Nkyoku/toro10_repo/TORO10Board/BOM.xlsx

Device | Model Number | Value | Package | Qty | Parts
Resistor |  | 0Ω | 1608 | 16 | R62, R64, R65, R67, R73, R75, R76, R78, R84, R86, R87, R89, R95, R97, R98, R100
Resistor | WSLF25121L000FEA (https://www.digikey.jp/product-detail/ja/vishay-dale/WSLF25121L000FEA/541-3125-1-ND/6194698) | 1mΩ | WSLF2512 | 1 | R5
Resistor |  | 2mΩ | 3216 | 8 | R63, R66, R74, R77, R85, R88, R96, R99
Resistor | PRL1632-R005-F-T1 (https://www.digikey.jp/product-detail/ja/susumu/PRL1632-R005-F-T1/PRL1632.005FCT-ND/948857) | 5mΩ | 3216WL | 2 | R24, R25
Resistor |  | 1Ω | 1608 | 5 | R60, R71, R82, R93, R104
Resistor |  | 51Ω | 1608 | 6 | R6, R7, R31, R32, R36, R43
Resistor |  | 1kΩ | 1608 | 14 | R4, R17, R29, R30, R51, R52, R69, R70, R80, R81, R91, R92, R102, R103
Resistor |  | 2.2kΩ | 1608 | 7 | R21, R33, R44, R45, R49, R53, R54
Resistor |  | 3.3kΩ | 1608 | 1 | R19
Resistor |  | 4.7kΩ | 1608 | 5 | R20, R27, R28, R39, R41
Resistor |  | 10kΩ | 1608 | 8 | R2, R10, R40, R46, R47, R48, R50, R55
Resistor |  | 15kΩ | 1608 | 1 | R12
Resistor |  | 22kΩ | 1608 | 6 | R9, R14, R61, R72, R83, R94
Resistor |  | 33kΩ | 1608 | 1 | R23
Resistor |  | 47kΩ | 1608 | 4 | R11, R16, R18, R105
Resistor |  | 68.1kΩ | 1608 | 1 | R22
Resistor |  | 130kΩ | 1608 | 2 | R13, R15
Resistor |  | 180kΩ | 1608 | 1 | R26
Resistor |  | 220kΩ | 1608 | 2 | R1, R3
Resistor |  | 270kΩ | 1608 | 1 | R8
Resistor Array |  | 51Ωx4 | 3216 | 5 | R34, R35, R37, R38, R42
Resistor Array |  | 1kΩx4 | 3216 | 4 | R56, R57, R58, R59
Resistor Array |  | 100kΩx4 | 3216 | 5 | R68, R79, R90, R101, R106
Ceramic Capacitor |  | Do Not Mount | 1608 | 8 | C54, C56, C67, C69, C82, C84, C95, C97
Ceramic Capacitor |  | 100pF | 1608 | 1 | C19
Ceramic Capacitor |  | 1nF | 1608 | 2 | C14, C20
Ceramic Capacitor |  | 10nF | 1608 | 3 | C17, C29, C38
Ceramic Capacitor |  | 100nF 63V | 1608 | 72 | C2, C3, C6, C21, C27, C28, C31, C40, C41, C46, C47, C48, C49, C50, C51, C52, C53, C55, C61, C62, C63, C64, C65, C66, C68, C74, C75, C76, C77, C78, C79, C80, C81, C83, C89, C90, C91, C92, C93, C94, C96, C102, C103, C104, C105, C106, C107, C108, C110, C111, C112, C113, C114, C115, C116, C117, C118, C119, C120, C121, C122, C123, C124, C125, C126, C127, C128, C129, C130, C131, C132, C133
Ceramic Capacitor |  | 1uF 63V | 1608 | 30 | C4, C5, C7, C16, C30, C32, C33, C34, C35, C37, C42, C43, C44, C45, C57, C58, C59, C60, C70, C71, C72, C73, C85, C86, C87, C88, C98, C99, C100, C101
Ceramic Capacitor | GRM21BB31E106KA (http://akizukidenshi.com/catalog/g/gP-07388/) | 10uF 16V | 2012 | 7 | C8, ,C9, C10, C15, C18, C39, C109
Ceramic Capacitor | GRM32ER7YA106KA12 (http://akizukidenshi.com/catalog/g/gP-06043/) | 10uF 35V | 3225 | 2 | C22, C23
Ceramic Capacitor | GRM32ER71J106MA12L (https://www.digikey.jp/product-detail/ja/murata-electronics-north-america/GRM32ER71J106MA12L/490-9971-1-ND/5026476) | 10uF 63V | 3225 | 2 | C24, C25
Ceramic Capacitor | GRM21BR61E226ME44 (http://akizukidenshi.com/catalog/g/gP-08240/) | 22uF 6.3V | 2012 | 1 | C36
Aluminum Capacitor | 35PK47MEFC5X11 (http://akizukidenshi.com/catalog/g/gP-03120/) | 47uF 35V | φ5mm | 1 | C1
Aluminum Capacitor | 25PK100MEFC5X11 (http://akizukidenshi.com/catalog/g/gP-03122/) | 100uF 16V | φ5mm | 3 | C11, C12, C13
Aluminum Capacitor | UPW1J391MHD6 (https://www.digikey.jp/product-detail/ja/nichicon/UPW1J391MHD6/493-1947-ND/589688) | 390uF 63V | φ18mm | 1 | C26
Inductor | MAMK2520T4R7M (https://www.digikey.jp/product-detail/ja/taiyo-yuden/MAMK2520T4R7M/587-3228-1-ND/3479462) | 4.7uH | 2520 | 5 | L1, L2, L3, L4, L5
Inductor | IHLP6767GZER8R2M11 (https://www.digikey.jp/product-detail/ja/vishay-dale/IHLP6767GZER8R2M11/541-1285-1-ND/2139411) | 8.2uH | 17.15mm x 17.15mm | 2 | L6, L7
Ferrite Bead | BLM18PG471SN1D (http://akizukidenshi.com/catalog/g/gP-04444/) |  | 1608 | 1 | FB1
Polyswitch | MICROSMD010F-02 (http://akizukidenshi.com/catalog/g/gP-09514/) |  | 3225 | 6 | F1, F2, F3, F4, F5, F6
Silicon Diode | GS1010FL (http://akizukidenshi.com/catalog/g/gI-06014/) |  | SOD123 | 10 | D11, D14, D15, D16, D17, D18, D19, D20, D21, D22
Schottky Diode | SS2040FL (http://akizukidenshi.com/catalog/g/gI-02073/) |  | SOD123 | 4 | D2, D3, D4, D5
Schottky Diode | FSV2060L (https://www.digikey.jp/product-detail/ja/fairchild-on-semiconductor/FSV2060L/FSV2060LCT-ND/5725011) |  | TO-277-3 | 2 | D7, D8
TVS Diode | SMAJ26A (https://www.digikey.jp/product-detail/ja/littelfuse-inc/SMAJ26A/SMAJ26ALFCT-ND/762502) |  | DO-214AC | 1 | D1
TVS Diode | SMAJ48A (https://www.digikey.jp/product-detail/ja/littelfuse-inc/SMAJ48A/SMAJ48ALFCT-ND/762516) |  | DO-214AC | 2 | D9, D10
LED |  | Green | 1608 | 1 | D12
LED |  | Orange | 1608 | 1 | D6
LED |  | Red | 1608 | 1 | D13
NPN Transistor | 2SC2712-GR (http://akizukidenshi.com/catalog/g/gI-00761/) |  | SOT23-3 | 2 | Q2, Q6
Nch MOSFET | BSS138 (http://akizukidenshi.com/catalog/g/gI-04232/) |  | SOT23-3 | 7 | Q1, Q3, Q4, Q5, Q10, Q11, Q12
Nch MOSFET | TPN7R506NH,L1Q (https://www.digikey.jp/product-detail/ja/toshiba-semiconductor-and-storage/TPN7R506NH,L1Q/TPN7R506NHL1QCT-ND/4876002) |  | TSON-8_3.3 | 2 | Q8, Q9
Pch MOSFET | SI7135DP-T1-GE3 (https://www.digikey.jp/product-detail/ja/vishay-siliconix/SI7135DP-T1-GE3/SI7135DP-T1-GE3CT-ND/1978869) |  | POWERPAK-SO-8-S | 1 | Q7
LDO Regulator | SPX3819M5-L-5-0/TR (https://www.digikey.jp/product-detail/ja/exar-corporation/SPX3819M5-L-5-0-TR/1016-1874-1-ND/3586591) |  | SOT23-5 | 1 | U10
Buck Regulator | LT3504EUFD#PBF (https://www.digikey.jp/product-detail/ja/linear-technology/LT3504EUFD-PBF/LT3504EUFD-PBF-ND/3481903) |  | QFN28-0.5 | 1 | U2
Boost Regulator | LTC3862EUH-1#PBF (https://www.digikey.jp/product-detail/ja/linear-technology/LTC3862EUH-1-PBF/LTC3862EUH-1-PBF-ND/1985771) |  | QFN24-0.65 | 1 | U3
Serializer | SN74LV165APWRG3 (https://www.digikey.jp/product-detail/ja/texas-instruments/SN74LV165APWRG3/296-31867-1-ND/3506089) |  | TSSOP16 | 2 | U11, U12
A/D Conveter | ADS7223SRHBT (https://www.digikey.jp/product-detail/ja/texas-instruments/ADS7223SRHBT/296-28186-1-ND/2522330) |  | QFN32-0.5 | 1 | U9
Oscillator | ASDMB-30.000MHZ-LC-T (https://www.digikey.jp/product-detail/ja/abracon-llc/ASDMB-30.000MHZ-LC-T/535-11733-1-ND/2809952) |  | 2520 | 1 | X1
EEPROM | 24AA02E48T-I/OT (https://www.digikey.jp/product-detail/ja/microchip-technology/24AA02E48T-I-OT/24AA02E48T-I-OTCT-ND/2003468) |  | SOT23-5 | 1 | U7
Flash Memory | IS25LP016D-JNLE (https://www.digikey.jp/product-detail/ja/issi-integrated-silicon-solution-inc/IS25LP016D-JNLE/706-1583-ND/6624232) |  | SOP8 | 1 | U5
I/O Expander | PCAL6416AHF,128 (https://www.digikey.jp/product-detail/ja/nxp-usa-inc/PCAL6416AHF,128/568-9946-1-ND/3721126) |  | QFN24-0.5 | 1 | U6
Motor Driver | DRV8312DDWR (https://www.digikey.jp/product-detail/ja/texas-instruments/DRV8312DDWR/296-29649-1-ND/2756423) |  | HTSSOP44 | 1 | U25
Motor Driver | DRV8332DKDR (https://www.digikey.jp/product-detail/ja/texas-instruments/DRV8332DKDR/296-29572-1-ND/2754251) |  | HSSOP36 | 4 | U13, U16, U19, U22
Inertial Measurement Unit | ICM-20689 (https://www.digikey.jp/product-detail/ja/invensense/ICM-20689/1428-1059-1-ND/5872874) |  | QFN24 | 1 | U8
Current Sense Amplifier | INA219AIDCNR (https://www.digikey.jp/product-detail/ja/texas-instruments/INA219AIDCNR/296-23770-1-ND/1952550) |  | SOT23-8 | 1 | U1
Current Sense Amplifier | INA240A2PWR (https://www.digikey.jp/product-detail/ja/texas-instruments/INA240A2PWR/296-45089-1-ND/6562102) |  | TSSOP8 | 8 | U14, U15, U17, U18, U20, U21, U23, U24
FPGA | 10M16SCE144C8G (https://www.digikey.jp/product-detail/ja/altera/10M16SCE144C8G/544-3111-ND/5284835) |  | QFP144 | 1 | U4
Piezoelectric Sounder | PKLCS1212E4001-R1 (http://akizukidenshi.com/catalog/g/gP-05723/) |  | PKLCS1212 | 1 | BZ1
Toggle Switch | B-12JV (http://akizukidenshi.com/catalog/g/gP-07658/) |  | B-12JV | 1 | SW1
Tactile Switch | EVQ-PUB02K (https://www.digikey.jp/product-detail/ja/panasonic-electronic-components/EVQ-PUB02K/P10848SCT-ND/286349) |  | EVQ-PU_BK | 2 | SW2, SW3
Header | 3557-20 (https://www.digikey.jp/product-detail/ja/keystone-electronics/3557-20/36-3557-20-ND/6149526) |  | 3557 | 1 | CN2
Header | 0430450801 (https://www.digikey.jp/product-detail/ja/molex-llc/0430450801/WM3253-ND/2405169) |  | 43045-0800 | 5 | CN3, CN12, CN14, CN16, CN18
Header | 0534260410 (https://www.digikey.jp/products/ja?keywords=53426-0410) |  | 53426-04 | 5 | CN11, CN13, CN15, CN17, CN19
Header | 0039301040 (https://www.digikey.jp/product-detail/ja/molex-llc/0039301040/WM1352-ND/561079) |  | 5569-04A2 | 1 | CN1
Pin Header | Pin Header 1x2 2.54mm Pitch |  | PIN1X2 | 2 | CN4, CN5
Pin Header | Pin Header 1x3 2.54mm Pitch |  | PIN1X3 | 1 | J1
Pin Header | Pin Header 1x8 2.54mm Pitch |  | PIN1X8 | 1 | CN20
Pin Header | Pin Header 2x3 2.54mm Pitch |  | PIN2X3 | 1 | CN8
Pin Header | Pin Header 2x5 1.27mm Pitch |  | PIN2X5-TH1.27 | 1 | CN10
Pin Header | Pin Header 2x5 2.54mm Pitch |  | PIN2X5 | 1 | CN9, J2
Pin Socket | 2209S-10G (http://akizukidenshi.com/catalog/g/gC-03870/) |  | SOCKET1X10-TH2.0 | 2 | CN6, CN7
