Nkyoku/toro10_repo/TORO10KickerBoard/BOM.xlsx

Device | Model Number | Value | Package | Qty | Parts
Resistor | WSL4026L3000FEB (https://www.digikey.jp/product-detail/ja/vishay-dale/WSL4026L3000FEB/WSLR-.0003CT-ND/2695229) | 0.3mΩ | WSL4026 | 1 | R26
Resistor |  | 10mΩ | 3216 | 1 | R19
Resistor |  | 10Ω | 2012 | 4 | R37, R38, R39, R40
Resistor |  | 10Ω | 3216 | 1 | R17
Resistor |  | 100Ω | 1608 | 3 | R1, R2, R18
Resistor |  | 1kΩ | 1608 | 4 | R7, R8, R22, R28
Resistor | PFS35-1KF1 (https://www.digikey.jp/product-detail/ja/riedon/PFS35-1KF1/696-1276-1-ND/2447886) | 1kΩ | D2PAK-3 | 1 | R32
Resistor |  | 1.5kΩ | 1608 | 1 | R16
Resistor |  | 2.2kΩ | 1608 | 4 | R3, R4, R5, R6
Resistor |  | 4.7kΩ | 1608 | 2 | R33, R34
Resistor |  | 10kΩ | 1608 | 4 | R9, R24, R25, R27
Resistor |  | 18kΩ ±1% | 1608 | 1 | R14
Resistor |  | 39kΩ ±1% | 1608 | 2 | R13, R15
Resistor | KTR18EZPF1003 (https://www.digikey.jp/product-detail/ja/rohm-semiconductor/KTR18EZPF1003/RHM100KAICT-ND/1984017) | 100kΩ ±1% | 3216 | 4 | R20, R21, R29, R30
Resistor |  | 180kΩ ±1% | 1608 | 1 | R12
Resistor |  | 330kΩ ±1% | 1608 | 1 | R10
Resistor |  | 510kΩ ±1% | 1608 | 1 | R11
Resistor | KTR18EZPF1004 (https://www.digikey.jp/product-detail/ja/rohm-semiconductor/KTR18EZPF1004/RHM1MAICT-ND/4071440) | 1MΩ | 3216 | 1 | R31
Resistor |  | Do Not Mount | 1608 | 2 | R35, R36
Potentiometer | TC33X-2-501E (https://www.digikey.jp/product-detail/ja/bourns-inc/TC33X-2-501E/TC33X-2-501ECT-ND/3437927) | 500Ω | TC33X | 1 | R23
Ceramic Capacitor |  | 1nF | 1608 | 1 | C14
Ceramic Capacitor |  | 10nF | 1608 | 2 | C15, C16
Ceramic Capacitor | GRM31BR72J103KW01L (https://www.digikey.jp/product-detail/ja/murata-electronics-north-america/GRM31BR72J103KW01L/490-3512-1-ND/789417) | 10nF 630V | 3225 | 1 | C17
Ceramic Capacitor |  | 100nF | 1608 | 8 | C3, C4, C8, C9, C10, C18, C19, C21
Ceramic Capacitor |  | 1uF | 1608 | 4 | C1, C2, C7, C20
Ceramic Capacitor | GRM21BB31E106KA (http://akizukidenshi.com/catalog/g/gP-07388/) | 10uF 16V | 2012 | 3 | C5, C6, C11
Ceramic Capacitor | GRM32ER7YA106KA12 (http://akizukidenshi.com/catalog/g/gP-06043/) | 10uF 35V | 3225 | 1 | C13
Aluminum Capacitor | 35ZLH220MEFCCT8X11.5 (http://akizukidenshi.com/catalog/g/gP-11758/) | 220uF | φ8mm | 1 | C12
Transformer | B64290L0638X087 (https://www.digikey.jp/product-detail/ja/epcos-tdk/B64290L0638X087/495-3865-ND/1830195) |  | TRANS-23.3X12.6X7.4 | 1 | K1
Fuse | 0501010.WR (https://www.digikey.jp/product-detail/ja/littelfuse-inc/0501010.WR/F1625CT-ND/2620103) | 10A | 3216 | 1 | F1
Ferrite Bead | BLM18PG471SN1D (http://akizukidenshi.com/catalog/g/gP-04444/) |  | 1608 | 1 | FB1
Silicon Diode | ES3G-E3/57T (https://www.digikey.jp/product-detail/ja/vishay-semiconductor-diodes-division/ES3G-E3-57T/ES3G-E3-57TGICT-ND/1091579) |  | DO-214AB | 1 | D5
Silicon Diode | AS4PG-M3/86A (https://www.digikey.jp/product-detail/ja/vishay-semiconductor-diodes-division/AS4PG-M3-86A/AS4PG-M3-86AGICT-ND/2709013) |  | SMPC | 2 | D8, D9
Schottky Diode | RB520S-30 (http://akizukidenshi.com/catalog/g/gI-05566/) |  | 1608 | 1 | D1
TVS Diode | SMAJ26A (https://www.digikey.jp/product-detail/ja/littelfuse-inc/SMAJ26A/SMAJ26ALFCT-ND/762502) |  | DO-214AC | 1 | D2
TVS Diode | SMAJ300A (https://www.digikey.jp/product-detail/ja/littelfuse-inc/SMAJ300A/SMAJ300ALFCT-ND/762560) |  | DO-214AC | 1 | D6
LED |  | Red | 1608 | 1 | D7
LED |  | Green | 1608 | 2 | D3
LED |  | Orange | 1608 | 2 | D4
Nch MOSFET | BSS138 (http://akizukidenshi.com/catalog/g/gI-04232/) |  | SOT23-3 | 3 | Q1, Q2, Q4
Nch MOSFET | BSP130,115 (https://www.digikey.jp/product-detail/ja/nexperia-usa-inc/BSP130,115/1727-4928-1-ND/2531507) |  | SOT223 | 1 | Q5
Nch MOSFET | CSD19538Q3A (https://www.digikey.jp/product-detail/ja/texas-instruments/CSD19538Q3A/296-44352-1-ND/6110625) |  | Q3A | 1 | Q3
IGBT |  |  | D2PAK-3 | 4 | Q6, Q7, Q8, Q9
Linear Regulator | NJM7805SDL1 (http://akizukidenshi.com/catalog/g/gI-11237/) |  | DPAK-3 | 1 | U2
Linear Regulator | NJM7812SDL1 (http://akizukidenshi.com/catalog/g/gI-10978/) |  | DPAK-3 | 1 | U1
Boost Regulator | LT3751EUFD#PBF (https://www.digikey.jp/product-detail/ja/linear-technology/LT3751EUFD-PBF/LT3751EUFD-PBF-ND/1973298) |  | QFN20-0.5-4X5 | 1 | U4
Current Sense Amplifier | INA181A1IDBVT (https://www.digikey.jp/product-detail/ja/texas-instruments/INA181A1IDBVT/296-46634-1-ND/7219070) |  | SOT23-6 | 1 | U5
Gate Driver | UCC27524DGNR, UCC27524ADGNR |  | MSOP8-PAD | 1 | U6
Microcontroller | ATSAMC21E18A-AUT (https://www.digikey.jp/product-detail/ja/microchip-technology/ATSAMC21E18A-AUT/1611-ATSAMC21E18A-AUTCT-ND/6832701) |  | QFP32-0.8 | 1 | U3
Header | 0436500800 (https://www.digikey.jp/product-detail/ja/molex-llc/0436500800/WM2424-ND/531340) |  | 43650-0800 | 1 | CN2
Header | 0039301020 (https://www.digikey.jp/product-detail/ja/molex-llc/0039301020/WM1351-ND/561078) |  | 5569-02A2 | 2 | CN5, CN6
Header | 0039301040 (https://www.digikey.jp/product-detail/ja/molex-llc/0039301040/WM1352-ND/561079) |  | 5569-04A2 | 1 | CN4
Pin Header | Pin Header 1x4 2.54mm Pitch |  | PIN1X4 | 1 | CN1
Pin Header | Pin Header 2x5 1.27mm Pitch |  | PIN2X5-SMT1.27 | 1 | CN3
