Nkyoku/toro10_repo/TORO10KickerBoard/design/LT3751.asc

C1: cap; 10n
C2: cap; 20u
C3: cap; 10n
D1: schottky; UPSC600
L1: ind2; 10u
L2: ind2; 1000u
M1: nmos; Si4486EY
R1: res; 100k
R2: res; 1MEG
R3: res; 5.1k
R4: res; 39k
R5: res; 18k
R6: res; 39k
R7: res; 10m
R8: res; 1.5k
R9: res; 180k
R11: res; 330k
R12: res; 510k
R13: res; 10
U1: LT3751
V1: voltage; 24
V2: voltage; PWL(0 0 +10u 2)
V3: voltage; 12
Named nets: 0, Vout, Vtrans, Vcc
K1 L1 L2 0.999
.tran 1
