Nkyoku/toro10_repo/TORO10Board/design/boost.asc

C1: cap; 10u; Rser=10m
C2: cap; 1n
C3: cap; 100n
C4: cap; 10n
C5: cap; 100p
C6: cap; 470u; Rser=50m
C7: cap; 10u; Rser=10m
D1: schottky; B560C
D2: schottky; B560C
L1: ind; 8.2u; Rser=8m
L2: ind; 8.2u; Rser=8m
M1: nmos; NTMFS5C646NL
M2: nmos; NTMFS5C646NL
R1: res; 5m
R2: res; 5m
R3: res; 68.1k
R4: res; 475k
R5: res; 12.4k
R6: res; 100
R8: res; 33k
U1: LTC3862-1
V1: voltage; PWL(0 0 100u 24)
V2: voltage; PWL(0 0 1m 0 +1u 3)
Named nets: 0, Vin, Vout
.tran 100m
