Nkyoku/toro10_repo/TORO10Board/design/surge.asc

C1: cap; 1m
C2: cap; 100n
D1: schottky; MBRB2545CT
M1: nmos; BSS123
M2: pmos; HAT1072H
M3: nmos; BSS123
M4: nmos; BSS123
M5: nmos; BSS123
Q1: npn; 2N3904
Q2: npn; 2N3904
R1: res; 100
R2: res; 220k
R3: res; 220k
R4: res; 10k
R5: res; 1k
V1: voltage; PWL(0 0 +100u 24 100m 24 +100u 0)
V2: voltage; PWL(0 0 1m 0 +10u 5 80m 5 +10u 0)
Named nets: 0, Vout
.tran 150m
