Nkyoku/toro10_repo/TORO10KickerBoard/toro10kicker.brd

## EAGLE design TORO10KickerBoard/toro10kicker.brd (2017-08-24)

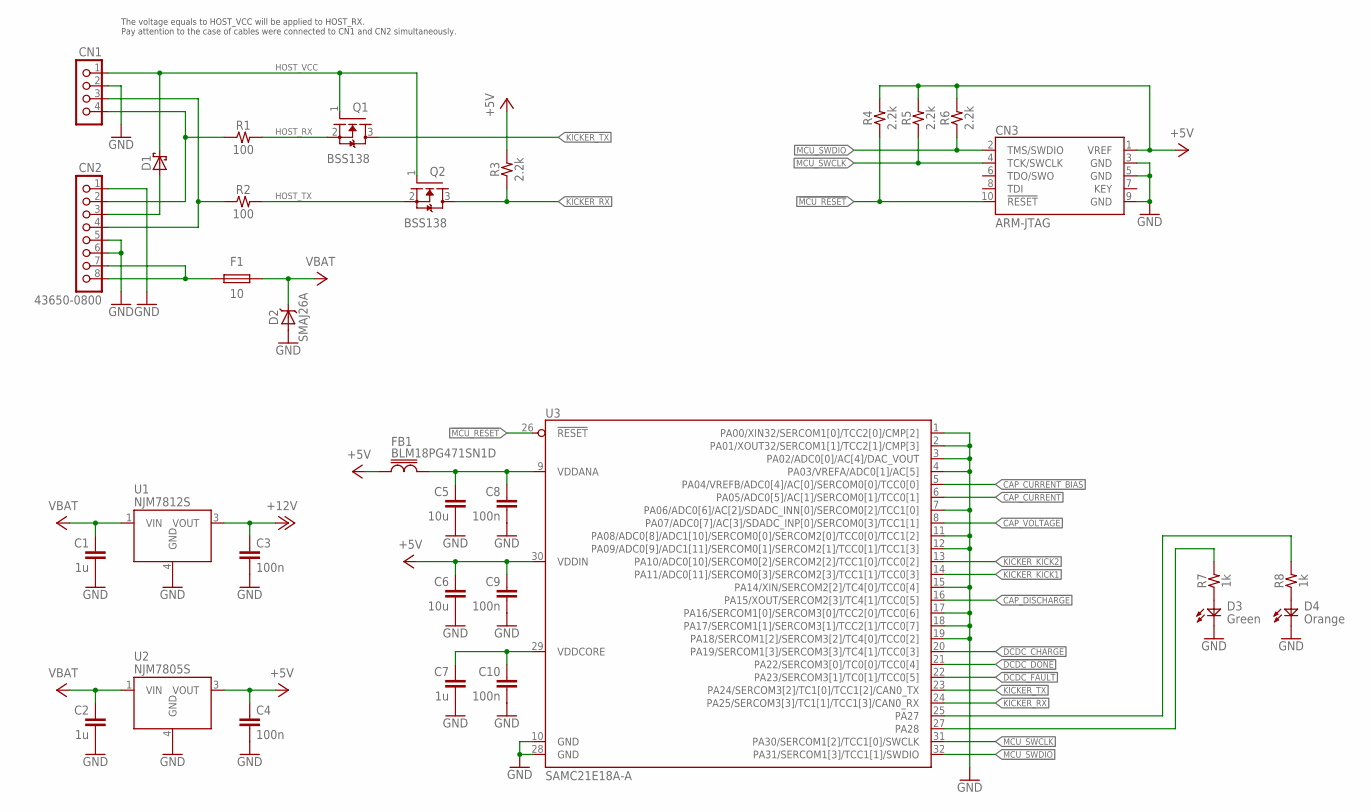
[picture p1: schematic toro10kicker.sch, sheet 1, Controller]

Parts:
C1, C2, C7: 1u; 1608
C3, C4, C8, C9, C10: 100n; 1608
C5, C6: 10u; 2012
CN1: PIN1X4
CN2: 43650-0800
CN3: ARM-JTAG; PIN2X5-SMT1.27
D1: SBD-1608; 1608D
D2: SMAJ26A; DO-214AC
D3: Green; 1608D
D4: Orange; 1608D
F1: 10; 3216
FB1: BLM18PG471SN1D; 1608
Q1, Q2: BSS138; SOT23-3
R1, R2: 100; 1608
R3, R4, R5, R6: 2.2k; 1608
R7, R8: 1k; 1608
U1: NJM7812S; DPAK-3
U2: NJM7805S; DPAK-3
U3: SAMC21E18A-A; QFP32-0.8

Connections:
!CAP_DISCHARGE: U3.16 (PA15/XOUT/SERCOM2[3]/TC4[1]/TCC0[5]); also elsewhere on the board
!DCDC_DONE: U3.21 (PA22/SERCOM3[0]/TC0[0]/TCC0[4]); also elsewhere on the board
!DCDC_FAULT: U3.22 (PA23/SERCOM3[1]/TC0[1]/TCC0[5]); also elsewhere on the board
!MCU_RESET: CN3.10 (!RESET), R4.1, U3.26 (!RESET)
+5V: C4.1, C6.1, C9.1, CN3.1 (VREF), FB1.1, R3.2, R4.2, R5.2, R6.2, U2.3 (VOUT), U3.30 (VDDIN); also elsewhere on the board
+12V: C3.1, U1.3 (VOUT); also elsewhere on the board
CAP_CURRENT: U3.6 (PA05/ADC0[5]/AC[1]/SERCOM0[1]/TCC0[1]); also elsewhere on the board
CAP_CURRENT_BIAS: U3.5 (PA04/VREFB/ADC0[4]/AC[0]/SERCOM0[0]/TCC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); also elsewhere on the board
CAP_VOLTAGE: U3.8 (PA07/ADC0[7]/AC[3]/SDADC_INP[0]/SERCOM0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); also elsewhere on the board
DCDC_CHARGE: U3.20 (PA19/SERCOM1[3]/SERCOM3[3]/TC4[1]/TCC0[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); also elsewhere on the board
GND: C1.2, C2.2, C3.2, C4.2, C5.2, C6.2, C7.2, C8.2, C9.2, C10.2, CN1.2, CN2.1, CN2.5, CN2.6, CN3.3 (GND), CN3.5 (GND), CN3.9 (GND), D2.A, D3.K, D4.K, U1.4 (GND), U2.4 (GND), U3.1 (PA00/XIN32/SERCOM1[0]/TCC2[0]/CMP[2]), U3.2 (PA01/XOUT32/SERCOM1[1]/TCC2[1]/CMP[3]), U3.3 (PA02/ADC0[0]/AC[4]/DAC_VOUT), U3.4 (PA03/VREFA/ADC0[1]/AC[5]), U3.7 (PA06/ADC0[6]/AC[2]/SDADC_INN[0]/SERCOM0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), U3.10 (GND), U3.11 (PA08/ADC0[8]/ADC1[10]/SERCOM0[0]/SERCOM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), U3.12 (PA09/ADC0[9]/ADC1[11]/SERCOM0[1]/SERCOM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), U3.15 (PA14/XIN/SERCOM2[2]/TC4[0]/TCC0[4]), U3.17 (PA16/SERCOM1[0]/SERCOM3[0]/TCC2[0]/TCC0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), U3.18 (PA17/SERCOM1[1]/SERCOM3[1]/TCC2[1]/TCC0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), U3.19 (PA18/SERCOM1[2]/SERCOM3[2]/TC4[0]/TCC0[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), U3.28 (GND); also elsewhere on the board
HOST_RX: Q1.2 (S), R1.2
HOST_TX: Q2.2 (S), R2.2
HOST_VCC: CN1.1, D1.K, Q1.1 (G), Q2.1 (G)
KICKER_KICK1: U3.14 (PA11/ADC0[11]/SERCOM0[3]/SERCOM2[3]/TCC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); also elsewhere on the board
KICKER_KICK2: U3.13 (PA10/ADC0[10]/SERCOM0[2]/SERCOM2[2]/TCC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); also elsewhere on the board
KICKER_RX: Q2.3 (D), R3.1, U3.24 (PA25/SERCOM3[3]/TC1[1]/TCC1[3]/CAN0_RX)
KICKER_TX: Q1.3 (D), U3.23 (PA24/SERCOM3[2]/TC1[0]/TCC1[2]/CAN0_TX)
MCU_SWCLK: CN3.4 (TCK/SWCLK), R5.1, U3.31 (PA30/SERCOM1[2]/TCC1[0]/SWCLK)
MCU_SWDIO: CN3.2 (TMS/SWDIO), R6.1, U3.32 (PA31/SERCOM1[3]/TCC1[1]/SWDIO)
unnamed: CN2.7, CN2.8, F1.1
unnamed: C5.1, C8.1, FB1.2, U3.9 (VDDANA)
unnamed: C7.1, C10.1, U3.29 (VDDCORE)
unnamed: CN1.4, CN2.2, R1.1
unnamed: CN1.3, CN2.4, R2.1
unnamed: D3.A, R7.1
unnamed: CN2.3, D1.A
unnamed: D4.A, R8.1
unnamed: R8.2, U3.25 (PA27)
unnamed: R7.2, U3.27 (PA28)
VBAT: C1.1, C2.1, D2.K, F1.2, U1.1 (VIN), U2.1 (VIN); also elsewhere on the board

Notes on the sheet:
The voltage equals to HOST_VCC will be applied to HOST_RX. Pay attention to the case of cables were connected to CN1 and CN2 simultaneously.

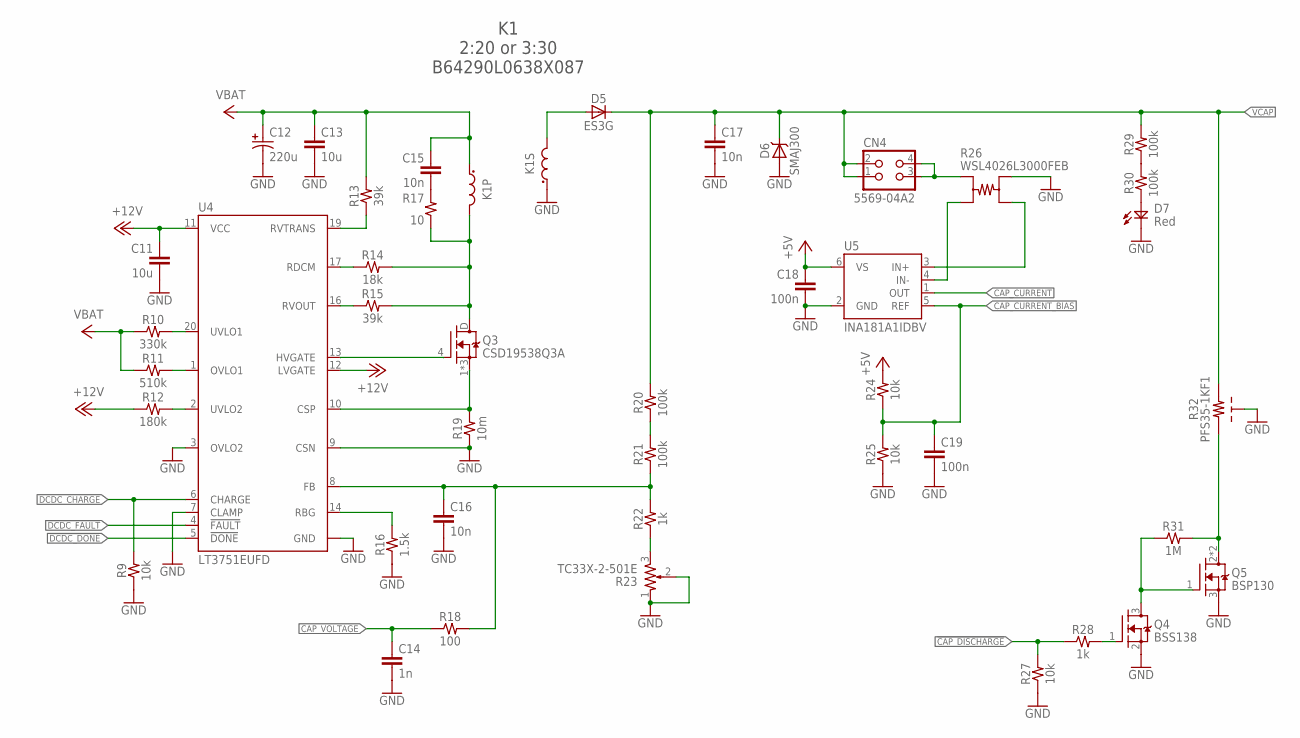
[picture p2: schematic toro10kicker.sch, sheet 2, Charger]

Parts:
C11: 10u; 2012
C12: 220u; E3.5-8
C13: 10u; 3225
C14: 1n; 1608
C15, C16: 10n; 1608
C17: 10n; 3225
C18, C19: 100n; 1608
CN4: 5569-04A2
D5: ES3G; DO-214AB
D6: SMAJ300; DO-214AC
D7: Red; 1608D
K1: TRANS; TRANS-23.3X12.6X7.4
Q3: CSD19538Q3A; Q3A
Q4: BSS138; SOT23-3
Q5: BSP130; SOT223
R9, R24, R25, R27: 10k; 1608
R10: 330k; 1608
R11: 510k; 1608
R12: 180k; 1608
R13, R15: 39k; 1608
R14: 18k; 1608
R16: 1.5k; 1608
R17: 10; 3216
R18: 100; 1608
R19: 10m; 3216
R20, R21, R29, R30: 100k; 3216
R22, R28: 1k; 1608
R23: TC33X-2-501E; TC33X
R26: WSL4026L3000FEB; WSL4026
R31: 1M; 3216
R32: PFS35-1KF1; D2PAK-3
U4: LT3751EUFD; QFN20-0.5-4X5
U5: INA181A1IDBV; SOT23-6

Connections:
!CAP_DISCHARGE: R27.2, R28.1; also elsewhere on the board
!DCDC_DONE: U4.5 (!DONE); also elsewhere on the board
!DCDC_FAULT: U4.4 (!FAULT); also elsewhere on the board
+5V: C18.1, R24.2, U5.6 (VS); also elsewhere on the board
+12V: C11.1, R12.1, U4.11 (VCC), U4.12 (LVGATE); also elsewhere on the board
CAP_CURRENT: U5.1 (OUT); also elsewhere on the board
CAP_CURRENT_BIAS: C19.1, R24.1, R25.2, U5.5 (REF); also elsewhere on the board
CAP_VOLTAGE: C14.1, R18.1; also elsewhere on the board
DCDC_CHARGE: R9.2, U4.6 (CHARGE); also elsewhere on the board
GND: C11.2, C12.N, C13.2, C14.2, C16.2, C17.2, C18.2, C19.2, D6.A, D7.K, K1.2A (1), Q4.2 (S), Q5.3 (S), R9.1, R16.1, R19.1, R23.1 (A), R23.2 (W), R25.1, R26.1A, R27.1, R32.4 (S), U4.3 (OVLO2), U4.7 (CLAMP), U4.9 (CSN), U4.PAD (GND), U5.2 (GND); also elsewhere on the board
unnamed: Q3.1 (S), Q3.2 (S), Q3.3 (S), R19.2, U4.10 (CSP)
unnamed: R10.2, U4.20 (UVLO1)
unnamed: R11.2, U4.1 (OVLO1)
unnamed: R12.2, U4.2 (UVLO2)
unnamed: Q5.2 (D), Q5.4 (D), R31.2, R32.1
unnamed: R14.1, U4.17 (RDCM)
unnamed: R15.1, U4.16 (RVOUT)
unnamed: K1.1B (2), Q3.D, R14.2, R15.2, R17.1
unnamed: R13.1, U4.19 (RVTRANS)
unnamed: Q3.4 (G), U4.13 (HVGATE)
unnamed: R22.1, R23.3 (B)
unnamed: C16.1, R18.2, R21.1, R22.2, U4.8 (FB)
unnamed: R16.2, U4.14 (RBG)
unnamed: CN4.3, CN4.4, R26.2A
unnamed: R29.1, R30.2
unnamed: D5.A, K1.2B (2)
unnamed: R20.1, R21.2
unnamed: Q4.3 (D), Q5.1 (G), R31.1
unnamed: C15.2, R17.2
unnamed: Q4.1 (G), R28.2
unnamed: D7.A, R30.1
unnamed: R26.2B, U5.4 (IN-)
unnamed: R26.1B, U5.3 (IN+)
VBAT: C12.P, C13.1, C15.1, K1.1A (1), R10.1, R11.1, R13.2; also elsewhere on the board
VCAP: C17.1, CN4.1, CN4.2, D5.K, D6.K, R20.2, R29.2, R32.3 (2); also elsewhere on the board

Notes on the sheet:
K1 2:20 or 3:30 B64290L0638X087

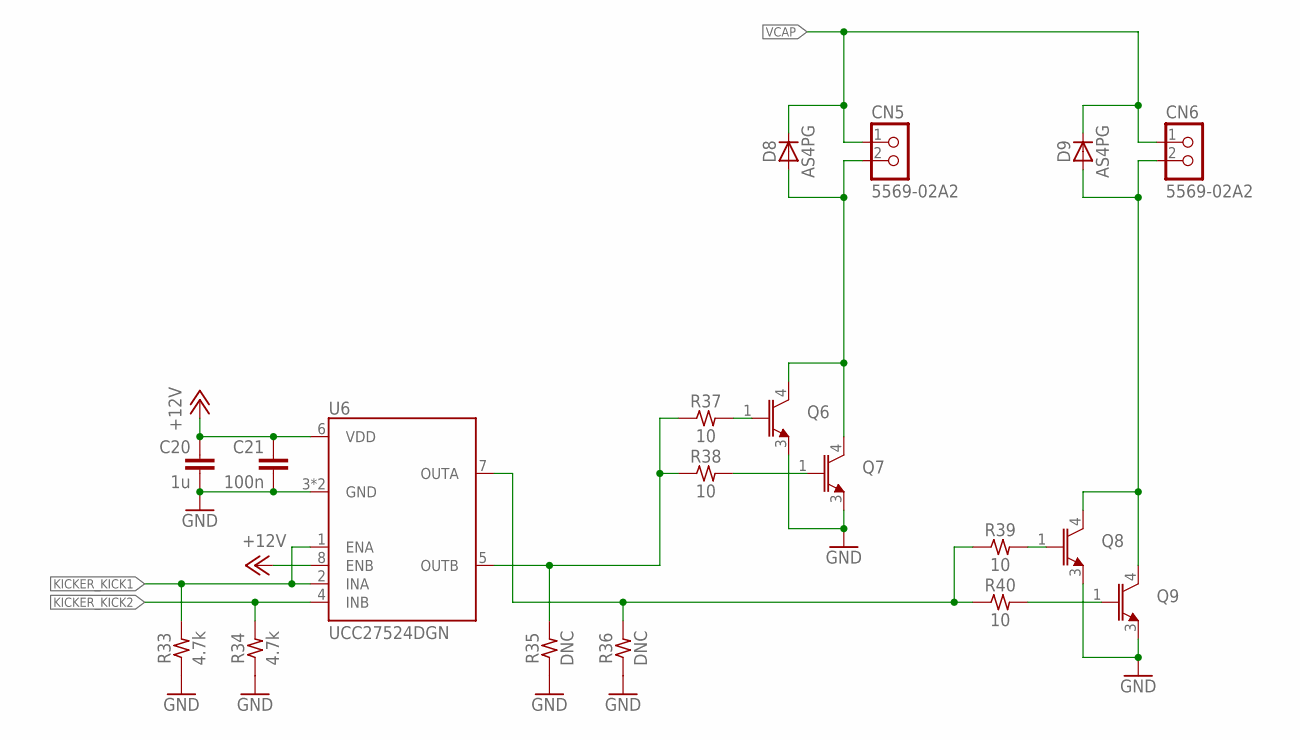
[picture p3: schematic toro10kicker.sch, sheet 3, Driver]

Parts:
C20: 1u; 1608
C21: 100n; 1608
CN5, CN6: 5569-02A2
D8, D9: AS4PG; SMPC
Q6, Q7, Q8, Q9: IGBT-N-D2PAK; D2PAK-3
R33, R34: 4.7k; 1608
R35, R36: DNC; 1608
R37, R38, R39, R40: 10; 2012
U6: UCC27524DGN; MSOP8-PAD

Connections:
+12V: C20.1, C21.1, U6.6 (VDD), U6.8 (ENB); also elsewhere on the board
GND: C20.2, C21.2, Q6.3 (E), Q7.3 (E), Q8.3 (E), Q9.3 (E), R33.1, R34.1, R35.1, R36.1, U6.3 (GND), U6.PAD (GND); also elsewhere on the board
KICKER_KICK1: R33.2, U6.1 (ENA), U6.2 (INA); also elsewhere on the board
KICKER_KICK2: R34.2, U6.4 (INB); also elsewhere on the board
unnamed: CN5.2, D8.1 (A), D8.2 (A), Q6.4 (C), Q7.4 (C)
unnamed: CN6.2, D9.1 (A), D9.2 (A), Q8.4 (C), Q9.4 (C)
unnamed: Q6.1 (G), R37.2
unnamed: Q7.1 (G), R38.2
unnamed: R35.2, R37.1, R38.1, U6.5 (OUTB)
unnamed: Q8.1 (G), R39.2
unnamed: Q9.1 (G), R40.2
unnamed: R36.2, R39.1, R40.1, U6.7 (OUTA)
VCAP: CN5.1, CN6.1, D8.K, D9.K; also elsewhere on the board

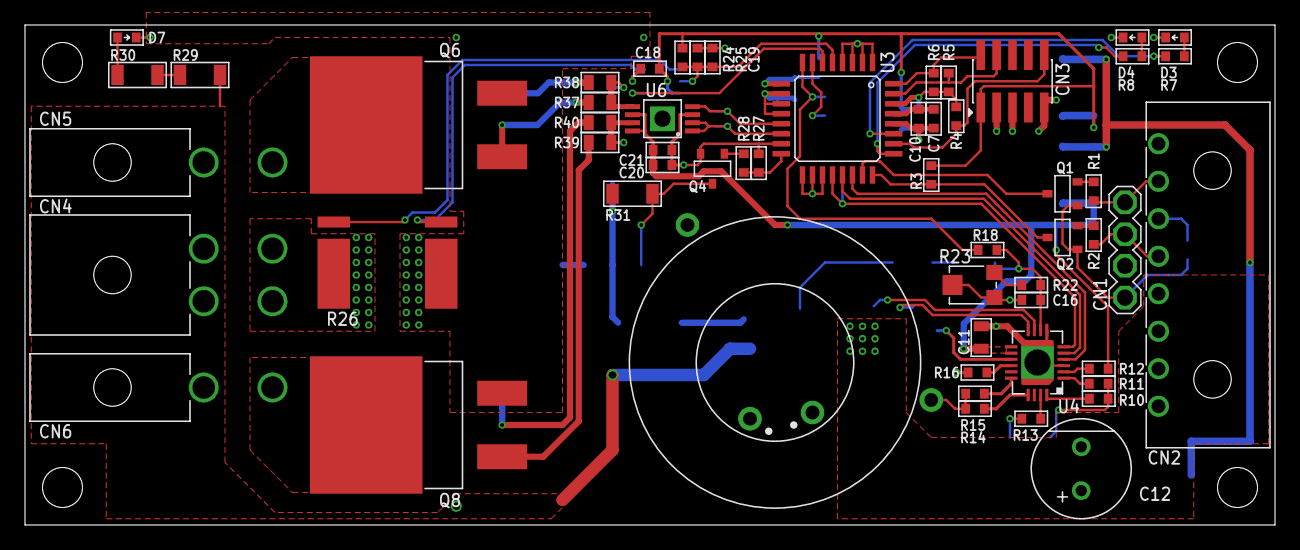
[picture p4: board toro10kicker.brd from above]

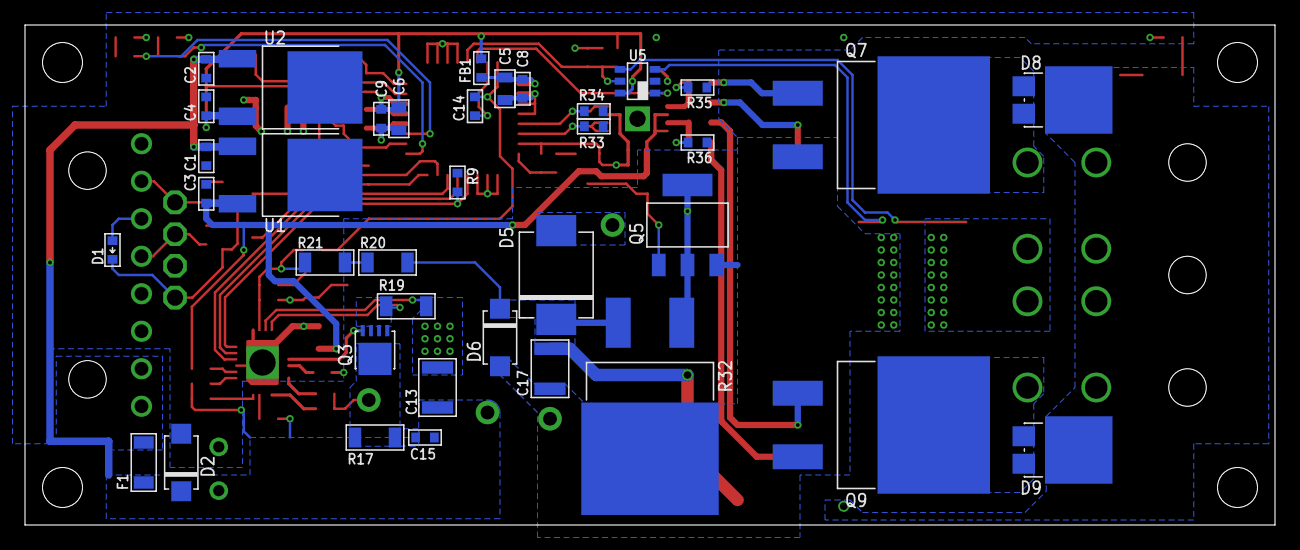
[picture p5: board toro10kicker.brd from below]

Board: 2 copper layers, 100.0 x 40.0 mm, 94 parts (37 on the bottom side), 63 nets.
