Nkyoku/toro10_repo/TORO10Board/toro10.brd

## EAGLE design TORO10Board/toro10.brd (2017-08-24)

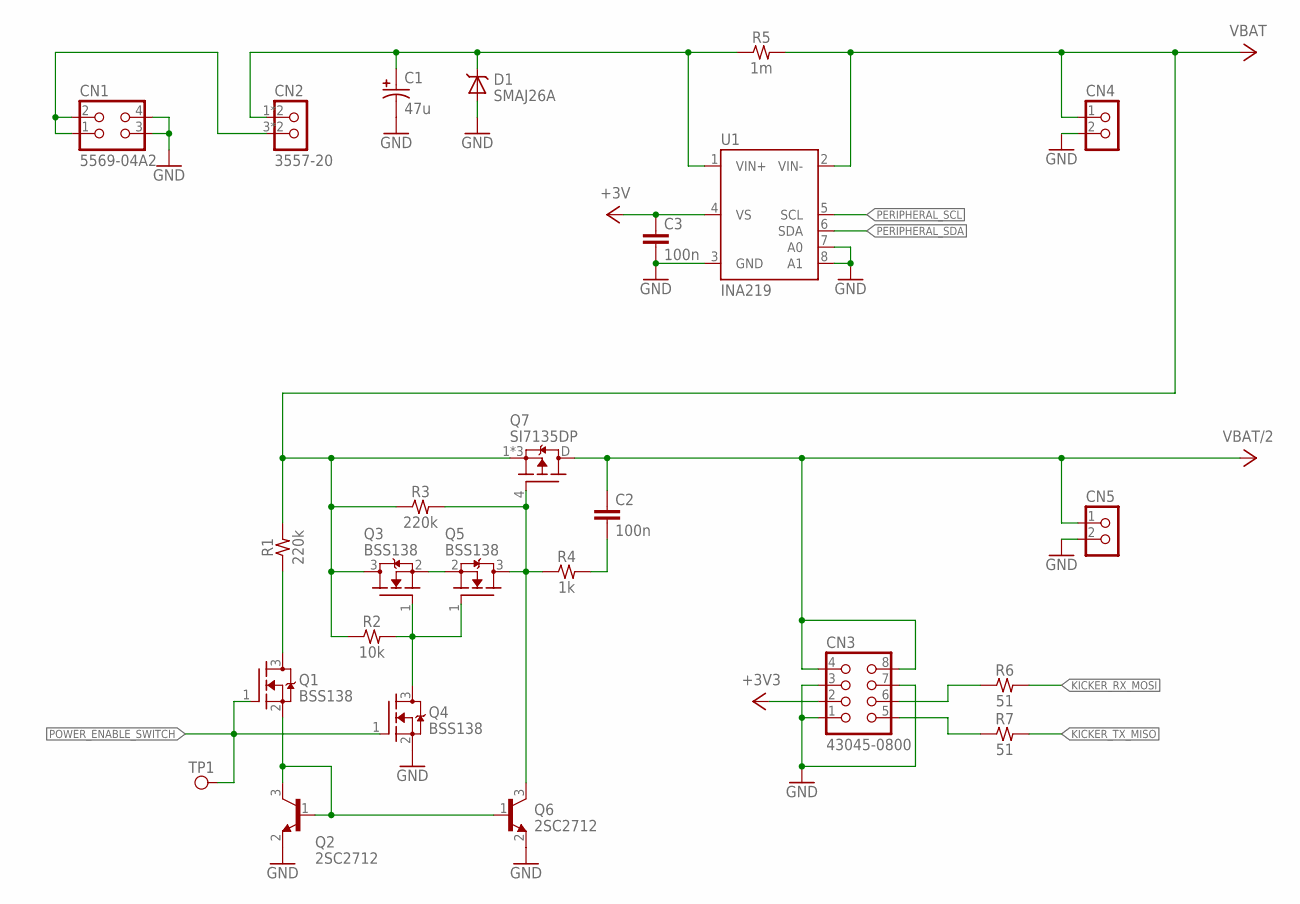
[picture p6: schematic toro10.sch, sheet 1, Power1]

Parts:
C1: 47u; E2-5
C2, C3: 100n; 1608
CN1: 5569-04A2
CN2: 3557-20; 3557
CN3: 43045-0800
CN4, CN5: PIN1X2
D1: SMAJ26A; DO-214AC
Q1, Q3, Q4, Q5: BSS138; SOT23-3
Q2, Q6: 2SC2712; SOT23-3
Q7: SI7135DP; POWERPAK-SO-8-S
R1, R3: 220k; 1608
R2: 10k; 1608
R4: 1k; 1608
R5: 1m; WSLF2512
R6, R7: 51; 1608
TP1: TESTPAD-SMT
U1: INA219; SOT23-8

Connections:
+3V: C3.1, U1.4 (VS); also elsewhere on the board
+3V3: CN3.2; also elsewhere on the board
GND: C1.N, C3.2, CN1.3, CN1.4, CN3.1, CN3.3, CN3.7, CN4.2, CN5.2, D1.A, Q2.2 (E), Q4.2 (S), Q6.2 (E), U1.3 (GND), U1.7 (A0), U1.8 (A1); also elsewhere on the board
KICKER_RX_MOSI: R6.2; also elsewhere on the board
KICKER_TX_MISO: R7.2; also elsewhere on the board
unnamed: CN1.1, CN1.2, CN2.3 (2), CN2.4 (2)
unnamed: Q3.2 (S), Q5.2 (S)
unnamed: Q3.1 (G), Q4.3 (D), Q5.1 (G), R2.2
unnamed: Q1.2 (S), Q2.1 (B), Q2.3 (C), Q6.1 (B)
unnamed: Q5.3 (D), Q6.3 (C), Q7.4 (G), R3.2, R4.1
unnamed: C2.2, R4.2
unnamed: Q1.3 (D), R1.1
unnamed: C1.P, CN2.1, CN2.2 (1), D1.K, R5.1, U1.1 (VIN+)
unnamed: CN3.6, R6.1
unnamed: CN3.5, R7.1
PERIPHERAL_SCL: U1.5 (SCL); also elsewhere on the board
PERIPHERAL_SDA: U1.6 (SDA); also elsewhere on the board
POWER_ENABLE_SWITCH: Q1.1 (G), Q4.1 (G), TP1.1; also elsewhere on the board
VBAT: CN4.1, Q3.3 (D), Q7.1 (S), Q7.2 (S), Q7.3 (S), R1.2, R2.1, R3.1, R5.2, U1.2 (VIN-); also elsewhere on the board
VBAT/2: C2.1, CN3.4, CN3.8, CN5.1, Q7.D; also elsewhere on the board

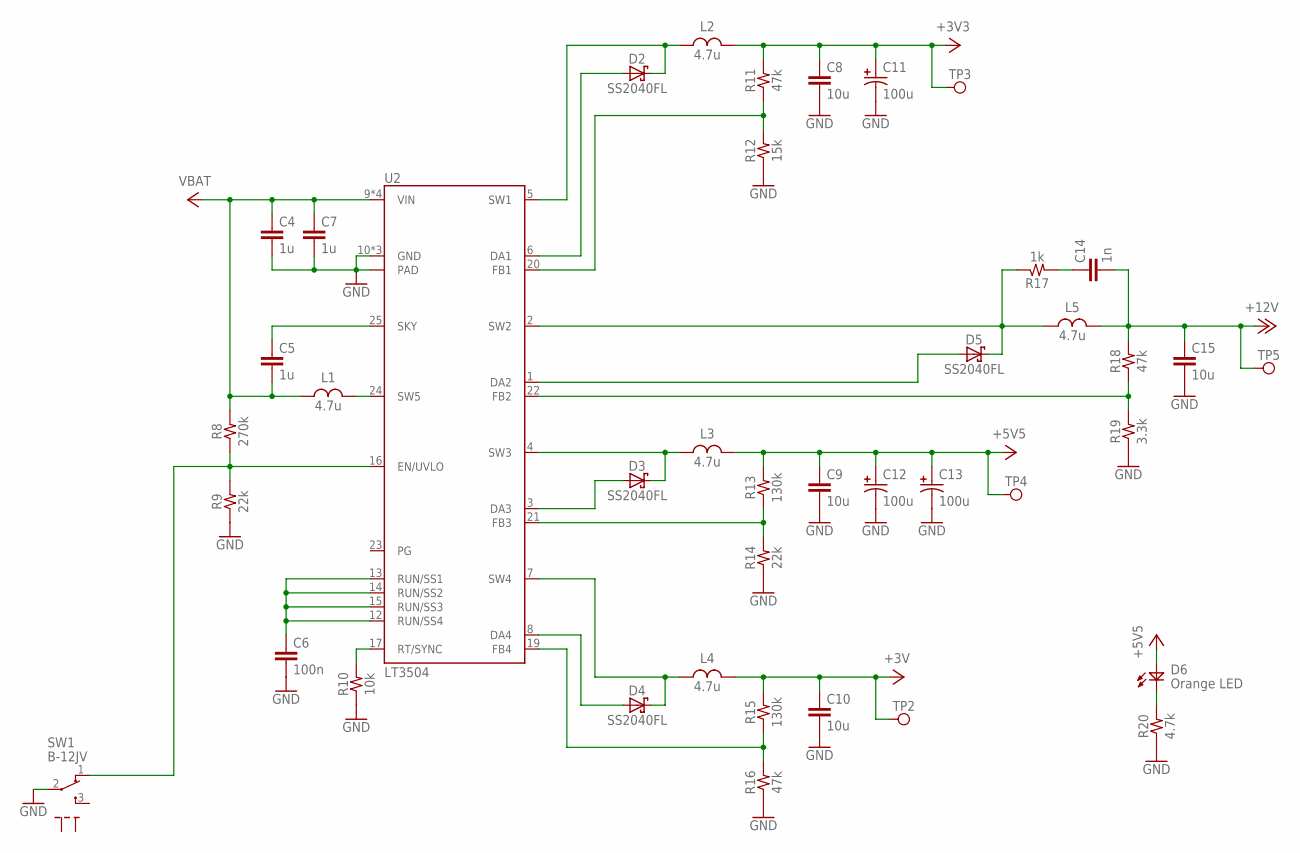
[picture p7: schematic toro10.sch, sheet 2, Power2]

Parts:
C4, C5, C7: 1u; 1608
C6: 100n; 1608
C8, C9, C10, C15: 10u; 2012
C11, C12, C13: 100u; E2-5
C14: 1n; 1608
D2, D3, D4, D5: SS2040FL; SOD123
D6: Orange LED; 1608D
L1, L2, L3, L4, L5: 4.7u; MAMK2520
R8: 270k; 1608
R9, R14: 22k; 1608
R10: 10k; 1608
R11, R16, R18: 47k; 1608
R12: 15k; 1608
R13, R15: 130k; 1608
R17: 1k; 1608
R19: 3.3k; 1608
R20: 4.7k; 1608
SW1: B-12JV
TP2, TP3, TP4, TP5: TESTPAD-TH
U2: LT3504; QFN28-0.5

Connections:
+3V: C10.1, L4.2, R15.2, TP2.1; also elsewhere on the board
+3V3: C8.1, C11.P, L2.2, R11.2, TP3.1; also elsewhere on the board
+5V5: C9.1, C12.P, C13.P, D6.A, L3.2, R13.2, TP4.1; also elsewhere on the board
+12V: C14.2, C15.1, L5.2, R18.2, TP5.1; also elsewhere on the board
GND: C4.2, C6.2, C7.2, C8.2, C9.2, C10.2, C11.N, C12.N, C13.N, C15.2, R9.1, R10.1, R12.1, R14.1, R16.1, R19.1, R20.1, SW1.2 (COM), U2.10 (GND), U2.18 (GND), U2.27 (GND), U2.PAD; also elsewhere on the board
unnamed: R18.1, R19.2, U2.22 (FB2)
unnamed: L1.2, U2.24 (SW5)
unnamed: C6.1, U2.12 (RUN/SS4), U2.13 (RUN/SS1), U2.14 (RUN/SS2), U2.15 (RUN/SS3)
unnamed: R10.2, U2.17 (RT/SYNC)
unnamed: C5.1, U2.25 (SKY)
unnamed: D2.K, L2.1, U2.5 (SW1)
unnamed: D5.K, L5.1, R17.1, U2.2 (SW2)
unnamed: R8.1, R9.2, SW1.1 (A), U2.16 (EN/UVLO)
unnamed: R15.1, R16.2, U2.19 (FB4)
unnamed: R11.1, R12.2, U2.20 (FB1)
unnamed: D5.A, U2.1 (DA2)
unnamed: R13.1, R14.2, U2.21 (FB3)
unnamed: D3.A, U2.3 (DA3)
unnamed: D3.K, L3.1, U2.4 (SW3)
unnamed: D4.K, L4.1, U2.7 (SW4)
unnamed: D4.A, U2.8 (DA4)
unnamed: C14.1, R17.2
unnamed: D2.A, U2.6 (DA1)
unnamed: D6.K, R20.2
VBAT: C4.1, C5.2, C7.1, L1.1, R8.2, U2.9 (VIN), U2.11 (VIN), U2.26 (VIN), U2.28 (VIN); also elsewhere on the board

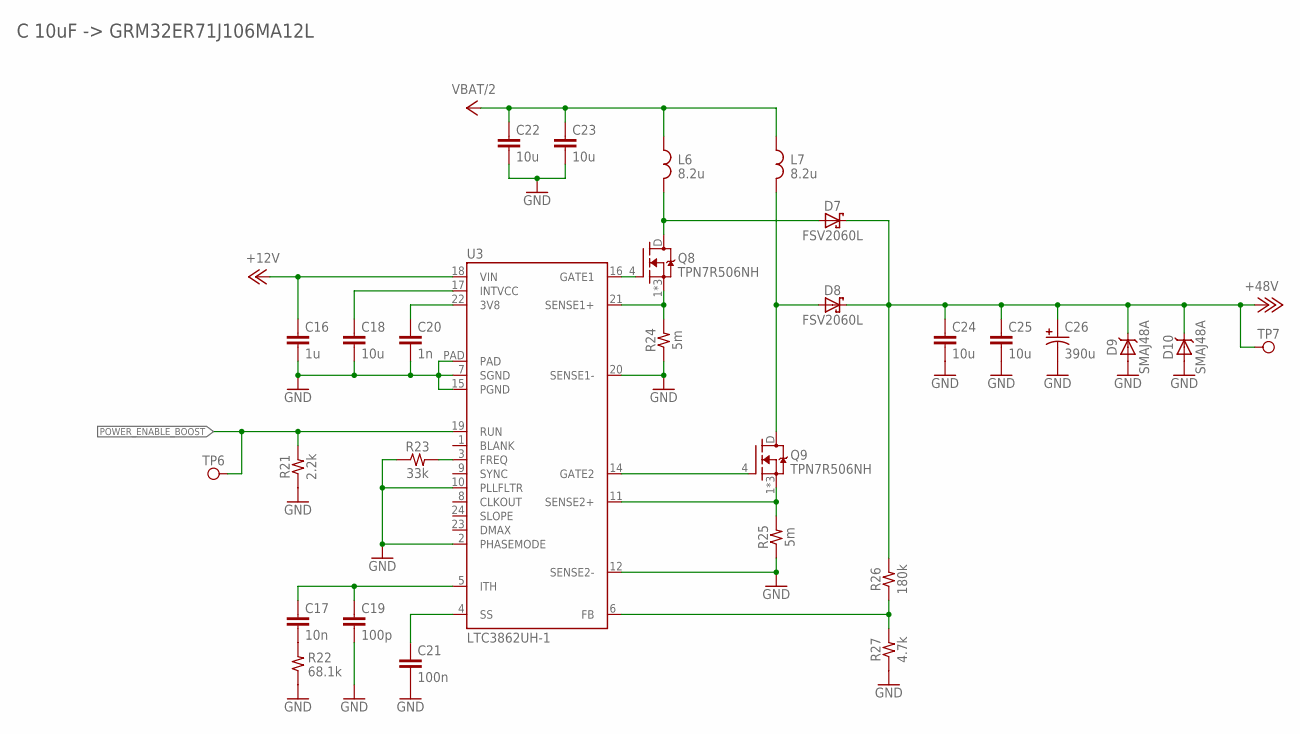
[picture p8: schematic toro10.sch, sheet 3, Power3]

Parts:
C16: 1u; 1608
C17: 10n; 1608
C18: 10u; 2012
C19: 100p; 1608
C20: 1n; 1608
C21: 100n; 1608
C22, C23, C24, C25: 10u; 3225
C26: 390u; E7.5-18
D7, D8: FSV2060L; TO-277-3
D9, D10: SMAJ48A; DO-214AC
L6, L7: 8.2u; L-VISHAY-ER
Q8, Q9: TPN7R506NH; TSON-8_3.3
R21: 2.2k; 1608
R22: 68.1k; 1608
R23: 33k; 1608
R24, R25: 5m; 3216WL
R26: 180k; 1608
R27: 4.7k; 1608
TP6, TP7: TESTPAD-SMT
U3: LTC3862UH-1; QFN24-0.65

Connections:
+12V: C16.1, U3.18 (VIN); also elsewhere on the board
+48V: C24.1, C25.1, C26.P, D7.3 (K), D8.3 (K), D9.K, D10.K, R26.2, TP7.1; also elsewhere on the board
GND: C16.2, C18.2, C19.2, C20.2, C21.2, C22.2, C23.2, C24.2, C25.2, C26.N, D9.A, D10.A, R21.1, R22.1, R23.1, R24.1, R25.1, R27.1, U3.2 (PHASEMODE), U3.7 (SGND), U3.10 (PLLFLTR), U3.12 (SENSE2-), U3.15 (PGND), U3.20 (SENSE1-), U3.PAD; also elsewhere on the board
unnamed: Q8.1 (S), Q8.2 (S), Q8.3 (S), R24.2, U3.21 (SENSE1+)
unnamed: C18.1, U3.17 (INTVCC)
unnamed: Q8.4 (G), U3.16 (GATE1)
unnamed: D7.1 (A), D7.2 (A), L6.2, Q8.D
unnamed: Q9.1 (S), Q9.2 (S), Q9.3 (S), R25.2, U3.11 (SENSE2+)
unnamed: C20.1, U3.22 (3V8)
unnamed: Q9.4 (G), U3.14 (GATE2)
unnamed: D8.1 (A), D8.2 (A), L7.2, Q9.D
unnamed: R26.1, R27.2, U3.6 (FB)
unnamed: C21.1, U3.4 (SS)
unnamed: C17.2, R22.2
unnamed: C17.1, C19.1, U3.5 (ITH)
unnamed: R23.2, U3.3 (FREQ)
POWER_ENABLE_BOOST: R21.2, TP6.1, U3.19 (RUN); also elsewhere on the board
VBAT/2: C22.1, C23.1, L6.1, L7.1; also elsewhere on the board

Notes on the sheet:
C 10uF -> GRM32ER71J106MA12L

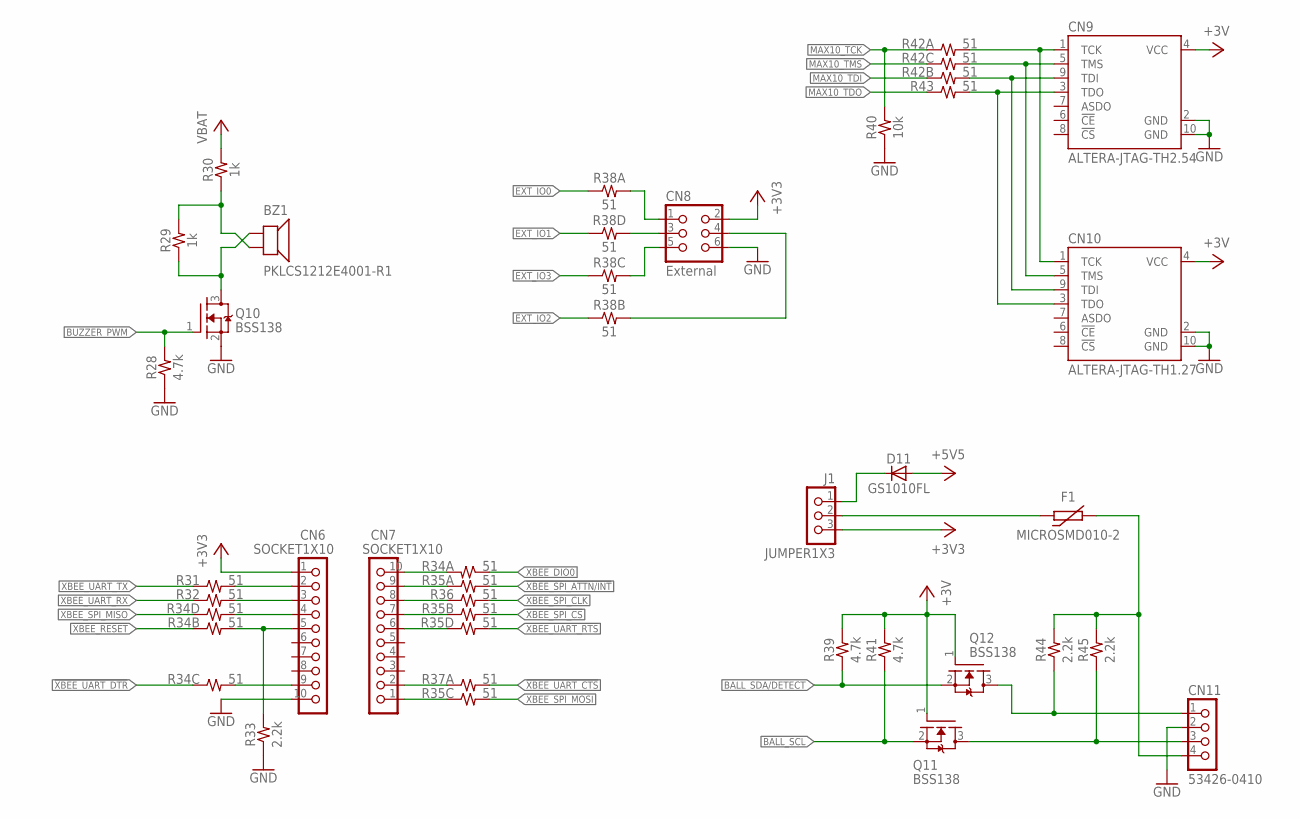
[picture p9: schematic toro10.sch, sheet 4, Interface]

Parts:
BZ1: PKLCS1212E4001-R1; PKLCS1212
CN6, CN7: SOCKET1X10; SOCKET1X10-TH2.0
CN8: External; PIN2X3
CN9: ALTERA-JTAG-TH2.54; PIN2X5
CN10: ALTERA-JTAG-TH1.27; PIN2X5-1.27
CN11: 53426-0410; 53426-04
D11: GS1010FL; SOD123
F1: MICROSMD010-2; 3225
J1: JUMPER1X3; PIN1X3
Q10, Q11, Q12: BSS138; SOT23-3
R28, R39, R41: 4.7k; 1608
R29, R30: 1k; 1608
R31, R32, R36, R43: 51; 1608
R33, R44, R45: 2.2k; 1608
R34, R35, R37, R38, R42: 51; 1608-4A
R40: 10k; 1608

Connections:
!XBEE_RESET: R34.B1 (1); also elsewhere on the board
!XBEE_SPI_ATTN/INT: R35.A2 (2); also elsewhere on the board
!XBEE_SPI_CS: R35.B2 (2); also elsewhere on the board
!XBEE_UART_CTS: R37.A2 (2); also elsewhere on the board
!XBEE_UART_DTR: R34.C1 (1); also elsewhere on the board
!XBEE_UART_RTS: R35.D2 (2); also elsewhere on the board
+3V: CN9.4 (VCC), CN10.4 (VCC), Q11.1 (G), Q12.1 (G), R39.2, R41.2; also elsewhere on the board
+3V3: CN6.1, CN8.2, J1.3; also elsewhere on the board
+5V5: D11.A; also elsewhere on the board
BALL_SCL: Q11.2 (S), R41.1; also elsewhere on the board
BALL_SDA/DETECT: Q12.2 (S), R39.1; also elsewhere on the board
BUZZER_PWM: Q10.1 (G), R28.2; also elsewhere on the board
EXT_IO0: R38.A1 (1); also elsewhere on the board
EXT_IO1: R38.D1 (1); also elsewhere on the board
EXT_IO2: R38.B1 (1); also elsewhere on the board
EXT_IO3: R38.C1 (1); also elsewhere on the board
GND: CN6.10, CN8.6, CN9.2 (GND), CN9.10 (GND), CN10.2 (GND), CN10.10 (GND), CN11.2, Q10.2 (S), R28.1, R33.1, R40.1; also elsewhere on the board
MAX10_TCK: R40.2, R42.A1 (1); also elsewhere on the board
MAX10_TDI: R42.B1 (1); also elsewhere on the board
MAX10_TDO: R43.1; also elsewhere on the board
MAX10_TMS: R42.C1 (1); also elsewhere on the board
unnamed: CN9.5 (TMS), CN10.5 (TMS), R42.C2 (2)
unnamed: CN9.9 (TDI), CN10.9 (TDI), R42.B2 (2)
unnamed: CN9.1 (TCK), CN10.1 (TCK), R42.A2 (2)
unnamed: BZ1.1, Q10.3 (D), R29.1
unnamed: CN9.3 (TDO), CN10.3 (TDO), R43.2
unnamed: CN8.1, R38.A2 (2)
unnamed: BZ1.2, R29.2, R30.1
unnamed: CN8.3, R38.D2 (2)
unnamed: CN8.5, R38.C2 (2)
unnamed: CN8.4, R38.B2 (2)
unnamed: CN11.4, F1.2, R44.2, R45.2
unnamed: D11.K, J1.1
unnamed: F1.1, J1.2
unnamed: CN11.3, Q11.3 (D), R45.1
unnamed: CN11.1, Q12.3 (D), R44.1
unnamed: CN7.2, R37.A1 (1)
unnamed: CN7.9, R35.A1 (1)
unnamed: CN7.7, R35.B1 (1)
unnamed: CN7.6, R35.D1 (1)
unnamed: CN7.1, R35.C1 (1)
unnamed: CN7.10, R34.A2 (2)
unnamed: CN6.4, R34.D2 (2)
unnamed: CN6.5, R33.2, R34.B2 (2)
unnamed: CN6.9, R34.C2 (2)
unnamed: CN7.8, R36.1
unnamed: CN6.2, R31.2
unnamed: CN6.3, R32.2
VBAT: R30.2; also elsewhere on the board
XBEE_DIO0: R34.A1 (1); also elsewhere on the board
XBEE_SPI_CLK: R36.2; also elsewhere on the board
XBEE_SPI_MISO: R34.D1 (1); also elsewhere on the board
XBEE_SPI_MOSI: R35.C2 (2); also elsewhere on the board
XBEE_UART_RX: R32.1; also elsewhere on the board
XBEE_UART_TX: R31.1; also elsewhere on the board
