Nkyoku/toro10_repo/TORO10Board/toro10.brd

## EAGLE design TORO10Board/toro10.brd (continued)

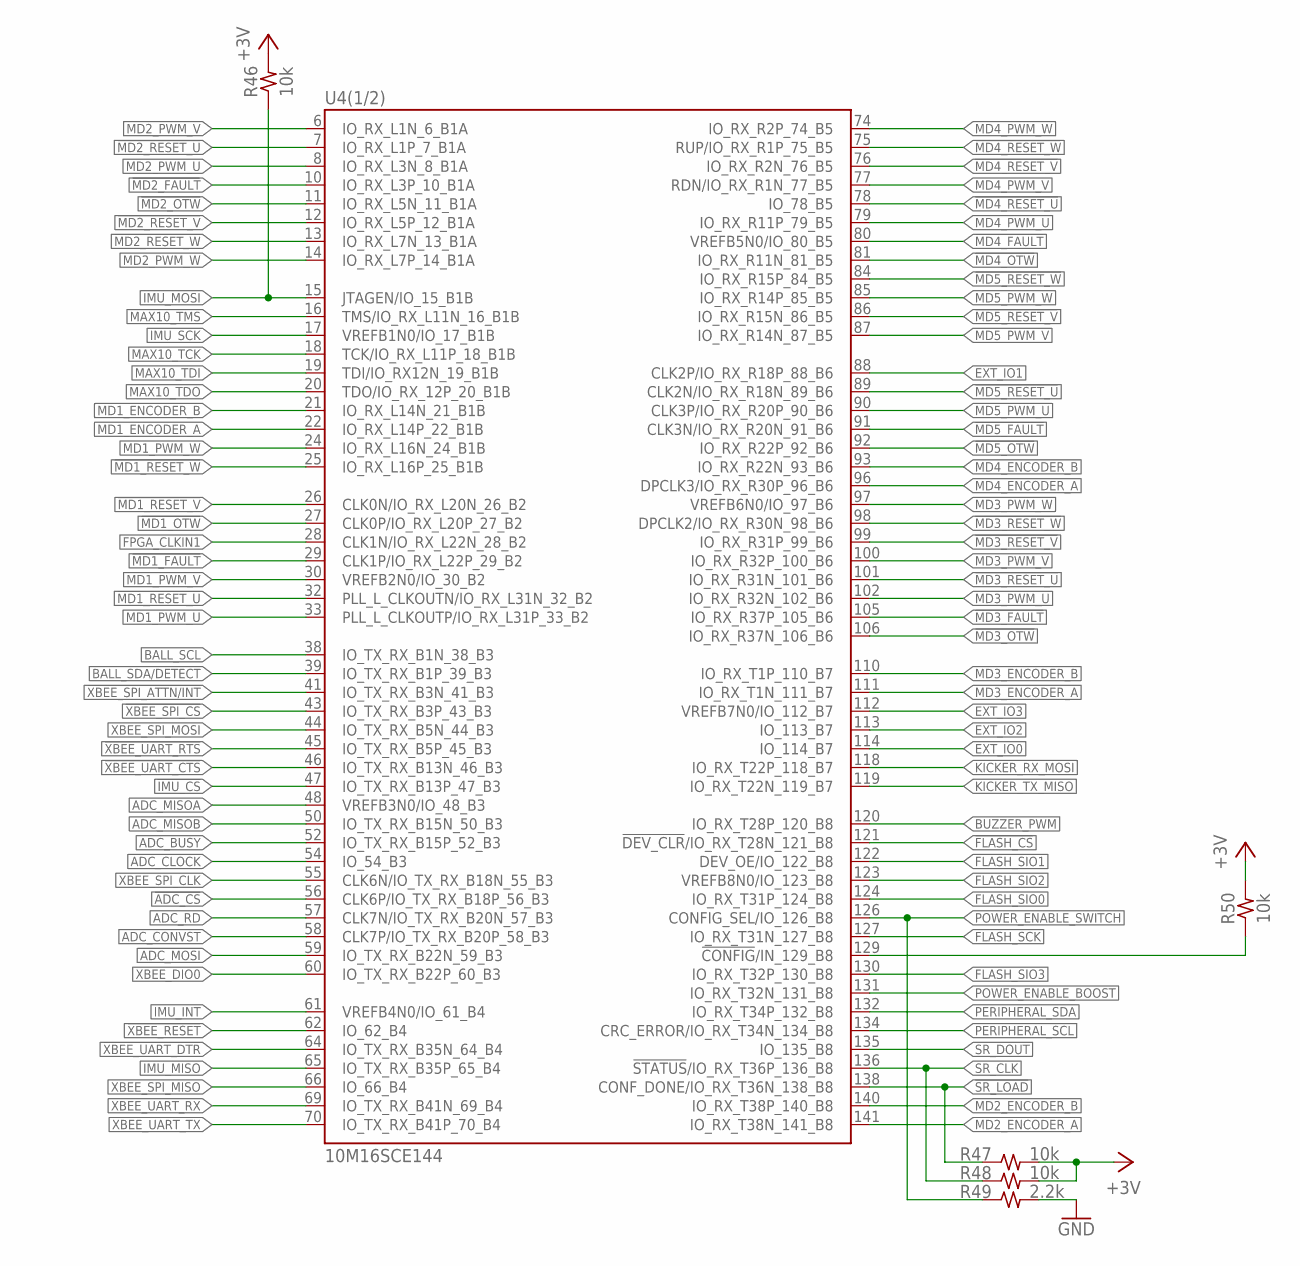
[picture p10: schematic toro10.sch, sheet 5, FPGA]

Parts:
R46, R47, R48, R50: 10k; 1608
R49: 2.2k; 1608
U4: 10M16SCE144; QFP144-0.5-PAD

Connections:
!ADC_CS: U4.56 (CLK6P/IO_TX_RX_B18P_56_B3); also elsewhere on the board
!FLASH_CS: U4.121 (!DEV_CLR!/IO_RX_T28N_121_B8); also elsewhere on the board
!IMU_CS: U4.47 (IO_TX_RX_B13P_47_B3); also elsewhere on the board
!MAX10_CONFIG: R50.1, U4.129 (!CONFIG!/IN_129_B8)
!MD1_FAULT: U4.29 (CLK1P/IO_RX_L22P_29_B2); also elsewhere on the board
!MD1_OTW: U4.27 (CLK0P/IO_RX_L20P_27_B2); also elsewhere on the board
!MD1_RESET_U: U4.32 (PLL_L_CLKOUTN/IO_RX_L31N_32_B2); also elsewhere on the board
!MD1_RESET_V: U4.26 (CLK0N/IO_RX_L20N_26_B2); also elsewhere on the board
!MD1_RESET_W: U4.25 (IO_RX_L16P_25_B1B); also elsewhere on the board
!MD2_FAULT: U4.10 (IO_RX_L3P_10_B1A); also elsewhere on the board
!MD2_OTW: U4.11 (IO_RX_L5N_11_B1A); also elsewhere on the board
!MD2_RESET_U: U4.7 (IO_RX_L1P_7_B1A); also elsewhere on the board
!MD2_RESET_V: U4.12 (IO_RX_L5P_12_B1A); also elsewhere on the board
!MD2_RESET_W: U4.13 (IO_RX_L7N_13_B1A); also elsewhere on the board
!MD3_FAULT: U4.105 (IO_RX_R37P_105_B6); also elsewhere on the board
!MD3_OTW: U4.106 (IO_RX_R37N_106_B6); also elsewhere on the board
!MD3_RESET_U: U4.101 (IO_RX_R31N_101_B6); also elsewhere on the board
!MD3_RESET_V: U4.99 (IO_RX_R31P_99_B6); also elsewhere on the board
!MD3_RESET_W: U4.98 (DPCLK2/IO_RX_R30N_98_B6); also elsewhere on the board
!MD4_FAULT: U4.80 (VREFB5N0/IO_80_B5); also elsewhere on the board
!MD4_OTW: U4.81 (IO_RX_R11N_81_B5); also elsewhere on the board
!MD4_RESET_U: U4.78 (IO_78_B5); also elsewhere on the board
!MD4_RESET_V: U4.76 (IO_RX_R2N_76_B5); also elsewhere on the board
!MD4_RESET_W: U4.75 (RUP/IO_RX_R1P_75_B5); also elsewhere on the board
!MD5_FAULT: U4.91 (CLK3N/IO_RX_R20N_91_B6); also elsewhere on the board
!MD5_OTW: U4.92 (IO_RX_R22P_92_B6); also elsewhere on the board
!MD5_RESET_U: U4.89 (CLK2N/IO_RX_R18N_89_B6); also elsewhere on the board
!MD5_RESET_V: U4.86 (IO_RX_R15N_86_B5); also elsewhere on the board
!MD5_RESET_W: U4.84 (IO_RX_R15P_84_B5); also elsewhere on the board
!SR_LOAD: R47.1, U4.138 (CONF_DONE/IO_RX_T36N_138_B8); also elsewhere on the board
!XBEE_RESET: U4.62 (IO_62_B4); also elsewhere on the board
!XBEE_SPI_ATTN/INT: U4.41 (IO_TX_RX_B3N_41_B3); also elsewhere on the board
!XBEE_SPI_CS: U4.43 (IO_TX_RX_B3P_43_B3); also elsewhere on the board
!XBEE_UART_CTS: U4.46 (IO_TX_RX_B13N_46_B3); also elsewhere on the board
!XBEE_UART_DTR: U4.64 (IO_TX_RX_B35N_64_B4); also elsewhere on the board
!XBEE_UART_RTS: U4.45 (IO_TX_RX_B5P_45_B3); also elsewhere on the board
+3V: R46.2, R47.2, R48.2, R50.2; also elsewhere on the board
ADC_BUSY: U4.52 (IO_TX_RX_B15P_52_B3); also elsewhere on the board
ADC_CLOCK: U4.54 (IO_54_B3); also elsewhere on the board
ADC_CONVST: U4.58 (CLK7P/IO_TX_RX_B20P_58_B3); also elsewhere on the board
ADC_MISOA: U4.48 (VREFB3N0/IO_48_B3); also elsewhere on the board
ADC_MISOB: U4.50 (IO_TX_RX_B15N_50_B3); also elsewhere on the board
ADC_MOSI: U4.59 (IO_TX_RX_B22N_59_B3); also elsewhere on the board
ADC_RD: U4.57 (CLK7N/IO_TX_RX_B20N_57_B3); also elsewhere on the board
BALL_SCL: U4.38 (IO_TX_RX_B1N_38_B3); also elsewhere on the board
BALL_SDA/DETECT: U4.39 (IO_TX_RX_B1P_39_B3); also elsewhere on the board
BUZZER_PWM: U4.120 (IO_RX_T28P_120_B8); also elsewhere on the board
EXT_IO0: U4.114 (IO_114_B7); also elsewhere on the board
EXT_IO1: U4.88 (CLK2P/IO_RX_R18P_88_B6); also elsewhere on the board
EXT_IO2: U4.113 (IO_113_B7); also elsewhere on the board
EXT_IO3: U4.112 (VREFB7N0/IO_112_B7); also elsewhere on the board
FLASH_SCK: U4.127 (IO_RX_T31N_127_B8); also elsewhere on the board
FLASH_SIO0: U4.124 (IO_RX_T31P_124_B8); also elsewhere on the board
FLASH_SIO1: U4.122 (DEV_OE/IO_122_B8); also elsewhere on the board
FLASH_SIO2: U4.123 (VREFB8N0/IO_123_B8); also elsewhere on the board
FLASH_SIO3: U4.130 (IO_RX_T32P_130_B8); also elsewhere on the board
FPGA_CLKIN1: U4.28 (CLK1N/IO_RX_L22N_28_B2); also elsewhere on the board
GND: R49.2; also elsewhere on the board
IMU_INT: U4.61 (VREFB4N0/IO_61_B4); also elsewhere on the board
IMU_MISO: U4.65 (IO_TX_RX_B35P_65_B4); also elsewhere on the board
IMU_MOSI: R46.1, U4.15 (JTAGEN/IO_15_B1B); also elsewhere on the board
IMU_SCK: U4.17 (VREFB1N0/IO_17_B1B); also elsewhere on the board
KICKER_RX_MOSI: U4.118 (IO_RX_T22P_118_B7); also elsewhere on the board
KICKER_TX_MISO: U4.119 (IO_RX_T22N_119_B7); also elsewhere on the board
MAX10_TCK: U4.18 (TCK/IO_RX_L11P_18_B1B); also elsewhere on the board
MAX10_TDI: U4.19 (TDI/IO_RX12N_19_B1B); also elsewhere on the board
MAX10_TDO: U4.20 (TDO/IO_RX_12P_20_B1B); also elsewhere on the board
MAX10_TMS: U4.16 (TMS/IO_RX_L11N_16_B1B); also elsewhere on the board
MD1_ENCODER_A: U4.22 (IO_RX_L14P_22_B1B); also elsewhere on the board
MD1_ENCODER_B: U4.21 (IO_RX_L14N_21_B1B); also elsewhere on the board
MD1_PWM_U: U4.33 (PLL_L_CLKOUTP/IO_RX_L31P_33_B2); also elsewhere on the board
MD1_PWM_V: U4.30 (VREFB2N0/IO_30_B2); also elsewhere on the board
MD1_PWM_W: U4.24 (IO_RX_L16N_24_B1B); also elsewhere on the board
MD2_ENCODER_A: U4.141 (IO_RX_T38N_141_B8); also elsewhere on the board
MD2_ENCODER_B: U4.140 (IO_RX_T38P_140_B8); also elsewhere on the board
MD2_PWM_U: U4.8 (IO_RX_L3N_8_B1A); also elsewhere on the board
MD2_PWM_V: U4.6 (IO_RX_L1N_6_B1A); also elsewhere on the board
MD2_PWM_W: U4.14 (IO_RX_L7P_14_B1A); also elsewhere on the board
MD3_ENCODER_A: U4.111 (IO_RX_T1N_111_B7); also elsewhere on the board
MD3_ENCODER_B: U4.110 (IO_RX_T1P_110_B7); also elsewhere on the board
MD3_PWM_U: U4.102 (IO_RX_R32N_102_B6); also elsewhere on the board
MD3_PWM_V: U4.100 (IO_RX_R32P_100_B6); also elsewhere on the board
MD3_PWM_W: U4.97 (VREFB6N0/IO_97_B6); also elsewhere on the board
MD4_ENCODER_A: U4.96 (DPCLK3/IO_RX_R30P_96_B6); also elsewhere on the board
MD4_ENCODER_B: U4.93 (IO_RX_R22N_93_B6); also elsewhere on the board
MD4_PWM_U: U4.79 (IO_RX_R11P_79_B5); also elsewhere on the board
MD4_PWM_V: U4.77 (RDN/IO_RX_R1N_77_B5); also elsewhere on the board
MD4_PWM_W: U4.74 (IO_RX_R2P_74_B5); also elsewhere on the board
MD5_PWM_U: U4.90 (CLK3P/IO_RX_R20P_90_B6); also elsewhere on the board
MD5_PWM_V: U4.87 (IO_RX_R14N_87_B5); also elsewhere on the board
MD5_PWM_W: U4.85 (IO_RX_R14P_85_B5); also elsewhere on the board
PERIPHERAL_SCL: U4.134 (CRC_ERROR/IO_RX_T34N_134_B8); also elsewhere on the board
PERIPHERAL_SDA: U4.132 (IO_RX_T34P_132_B8); also elsewhere on the board
POWER_ENABLE_BOOST: U4.131 (IO_RX_T32N_131_B8); also elsewhere on the board
POWER_ENABLE_SWITCH: R49.1, U4.126 (CONFIG_SEL/IO_126_B8); also elsewhere on the board
SR_CLK: R48.1, U4.136 (!STATUS!/IO_RX_T36P_136_B8); also elsewhere on the board
SR_DOUT: U4.135 (IO_135_B8); also elsewhere on the board
XBEE_DIO0: U4.60 (IO_TX_RX_B22P_60_B3); also elsewhere on the board
XBEE_SPI_CLK: U4.55 (CLK6N/IO_TX_RX_B18N_55_B3); also elsewhere on the board
XBEE_SPI_MISO: U4.66 (IO_66_B4); also elsewhere on the board
XBEE_SPI_MOSI: U4.44 (IO_TX_RX_B5N_44_B3); also elsewhere on the board
XBEE_UART_RX: U4.69 (IO_TX_RX_B41N_69_B4); also elsewhere on the board
XBEE_UART_TX: U4.70 (IO_TX_RX_B41P_70_B4); also elsewhere on the board

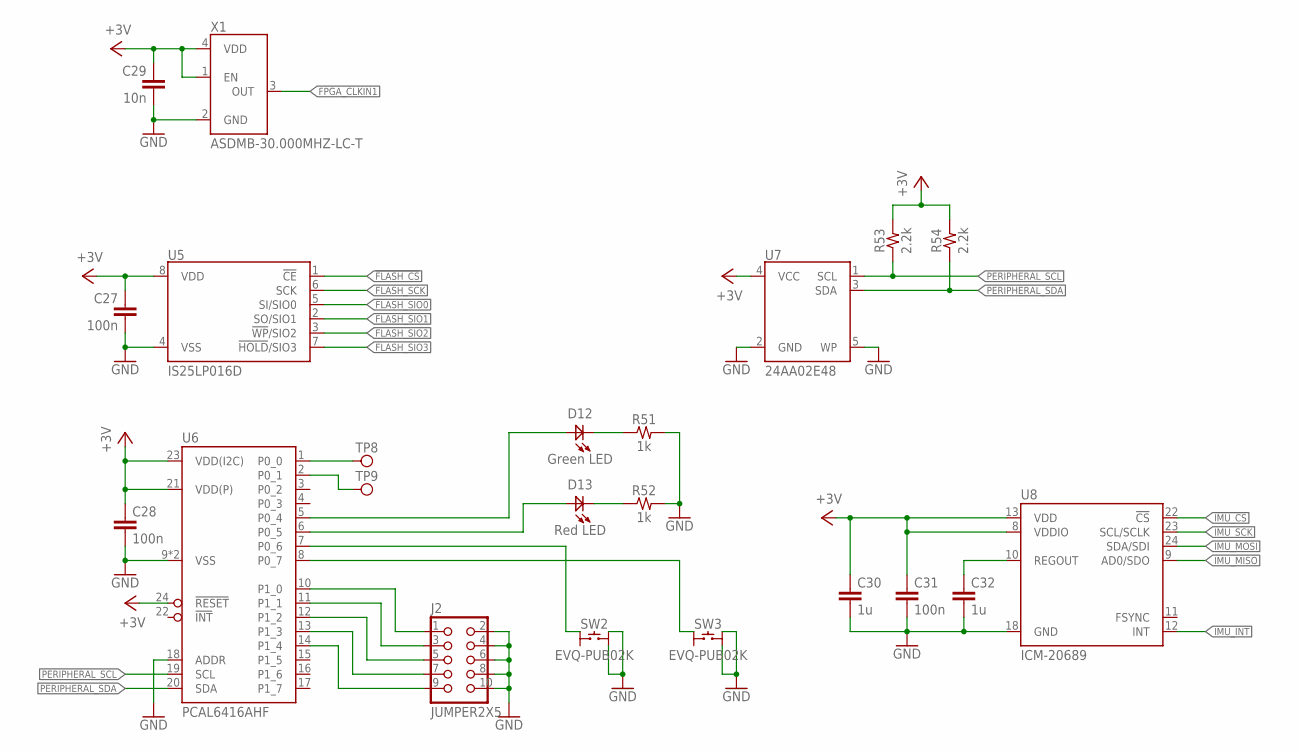
[picture p11: schematic toro10.sch, sheet 6, Peripheral]

Parts:
C27, C28, C31: 100n; 1608
C29: 10n; 1608
C30, C32: 1u; 1608
D12: Green LED; 1608D
D13: Red LED; 1608D
J2: JUMPER2X5; PIN2X5
R51, R52: 1k; 1608
R53, R54: 2.2k; 1608
SW2, SW3: EVQ-PUB02K; EVQ-PU_BK
TP8, TP9: TESTPAD-SMT
U5: IS25LP016D; SOP8
U6: PCAL6416AHF; QFN24-0.5
U7: 24AA02E48; SOT23-5
U8: ICM-20689; QFN24-0.5-INVEN
X1: ASDMB-30.000MHZ-LC-T; OSC2520

Connections:
!FLASH_CS: U5.1 (!CE); also elsewhere on the board
!IMU_CS: U8.22 (!CS); also elsewhere on the board
+3V: C27.1, C28.1, C29.1, C30.1, C31.1, R53.2, R54.2, U5.8 (VDD), U6.21 (VDD(P)), U6.23 (VDD(I2C)), U6.24 (!RESET), U7.4 (VCC), U8.8 (VDDIO), U8.13 (VDD), X1.1 (EN), X1.4 (VDD); also elsewhere on the board
FLASH_SCK: U5.6 (SCK); also elsewhere on the board
FLASH_SIO0: U5.5 (SI/SIO0); also elsewhere on the board
FLASH_SIO1: U5.2 (SO/SIO1); also elsewhere on the board
FLASH_SIO2: U5.3 (!WP!/SIO2); also elsewhere on the board
FLASH_SIO3: U5.7 (!HOLD!/SIO3); also elsewhere on the board
FPGA_CLKIN1: X1.3 (OUT); also elsewhere on the board
GND: C27.2, C28.2, C29.2, C30.2, C31.2, C32.2, J2.2, J2.4, J2.6, J2.8, J2.10, R51.2, R52.2, SW2.A1, SW2.A2, SW3.A1, SW3.A2, U5.4 (VSS), U6.9 (VSS), U6.18 (ADDR), U6.PAD (VSS), U7.2 (GND), U7.5 (WP), U8.18 (GND), X1.2 (GND); also elsewhere on the board
IMU_INT: U8.12 (INT); also elsewhere on the board
IMU_MISO: U8.9 (AD0/SDO); also elsewhere on the board
IMU_MOSI: U8.24 (SDA/SDI); also elsewhere on the board
IMU_SCK: U8.23 (SCL/SCLK); also elsewhere on the board
unnamed: D12.A, U6.5 (P0_4)
unnamed: D13.A, U6.6 (P0_5)
unnamed: J2.1, U6.10 (P1_0)
unnamed: J2.3, U6.11 (P1_1)
unnamed: J2.5, U6.12 (P1_2)
unnamed: J2.7, U6.13 (P1_3)
unnamed: J2.9, U6.14 (P1_4)
unnamed: SW3.B1, U6.8 (P0_7)
unnamed: SW2.B1, U6.7 (P0_6)
unnamed: TP8.1, U6.1 (P0_0)
unnamed: TP9.1, U6.2 (P0_1)
unnamed: D12.K, R51.1
unnamed: D13.K, R52.1
unnamed: C32.1, U8.10 (REGOUT)
PERIPHERAL_SCL: R53.1, U6.19 (SCL), U7.1 (SCL); also elsewhere on the board
PERIPHERAL_SDA: R54.1, U6.20 (SDA), U7.3 (SDA); also elsewhere on the board

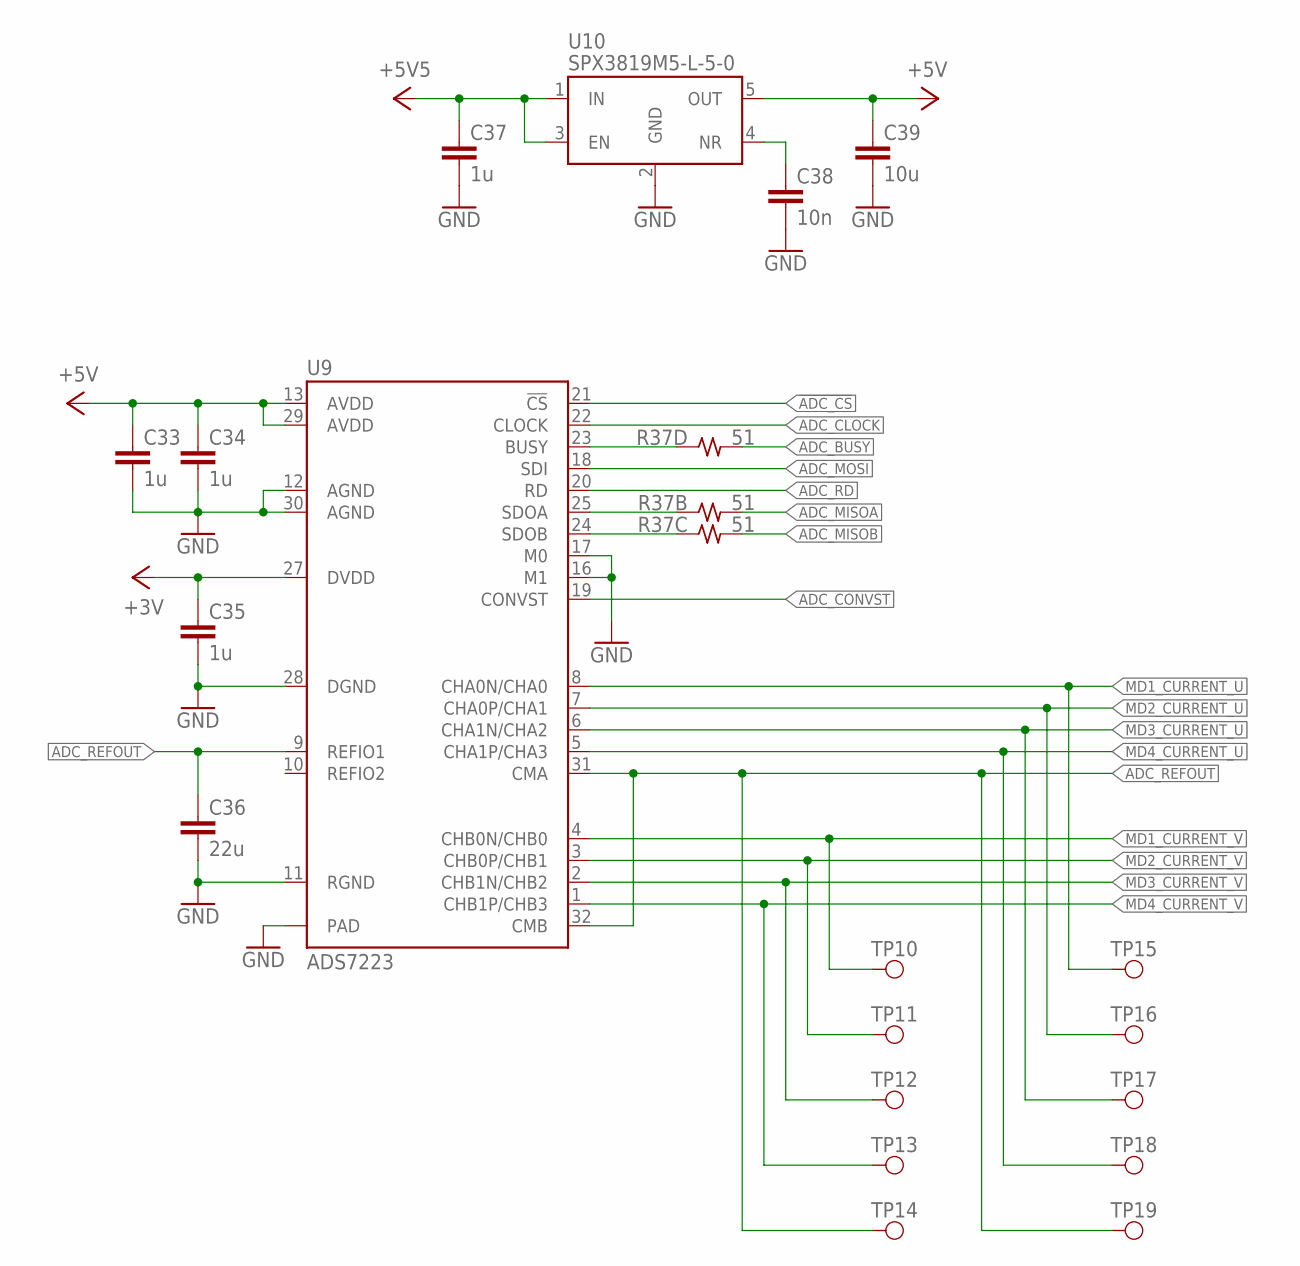
[picture p12: schematic toro10.sch, sheet 7, MD Analog]

Parts:
C33, C34, C35, C37: 1u; 1608
C36: 22u; 2012
C38: 10n; 1608
C39: 10u; 2012
R37: 51; 1608-4A
TP10, TP11, TP12, TP13, TP14, TP15, TP16, TP17, TP18, TP19: TESTPAD-TH
U9: ADS7223; QFN32-0.5
U10: SPX3819M5-L-5-0; SOT23-5

Connections:
!ADC_CS: U9.21 (!CS); also elsewhere on the board
+3V: C35.1, U9.27 (DVDD); also elsewhere on the board
+5V: C33.1, C34.1, C39.1, U9.13 (AVDD), U9.29 (AVDD), U10.5 (OUT); also elsewhere on the board
+5V5: C37.1, U10.1 (IN), U10.3 (EN); also elsewhere on the board
ADC_BUSY: R37.D2 (2); also elsewhere on the board
ADC_CLOCK: U9.22 (CLOCK); also elsewhere on the board
ADC_CONVST: U9.19 (CONVST); also elsewhere on the board
ADC_MISOA: R37.B2 (2); also elsewhere on the board
ADC_MISOB: R37.C2 (2); also elsewhere on the board
ADC_MOSI: U9.18 (SDI); also elsewhere on the board
ADC_RD: U9.20 (RD); also elsewhere on the board
ADC_REFOUT: C36.1, TP14.1, TP19.1, U9.9 (REFIO1), U9.31 (CMA), U9.32 (CMB); also elsewhere on the board
GND: C33.2, C34.2, C35.2, C36.2, C37.2, C38.2, C39.2, U9.11 (RGND), U9.12 (AGND), U9.16 (M1), U9.17 (M0), U9.28 (DGND), U9.30 (AGND), U9.PAD, U10.2 (GND); also elsewhere on the board
MD1_CURRENT_U: TP15.1, U9.8 (CHA0N/CHA0); also elsewhere on the board
MD1_CURRENT_V: TP10.1, U9.4 (CHB0N/CHB0); also elsewhere on the board
MD2_CURRENT_U: TP16.1, U9.7 (CHA0P/CHA1); also elsewhere on the board
MD2_CURRENT_V: TP11.1, U9.3 (CHB0P/CHB1); also elsewhere on the board
MD3_CURRENT_U: TP17.1, U9.6 (CHA1N/CHA2); also elsewhere on the board
MD3_CURRENT_V: TP12.1, U9.2 (CHB1N/CHB2); also elsewhere on the board
MD4_CURRENT_U: TP18.1, U9.5 (CHA1P/CHA3); also elsewhere on the board
MD4_CURRENT_V: TP13.1, U9.1 (CHB1P/CHB3); also elsewhere on the board
unnamed: C38.1, U10.4 (NR)
unnamed: R37.D1 (1), U9.23 (BUSY)
unnamed: R37.B1 (1), U9.25 (SDOA)
unnamed: R37.C1 (1), U9.24 (SDOB)

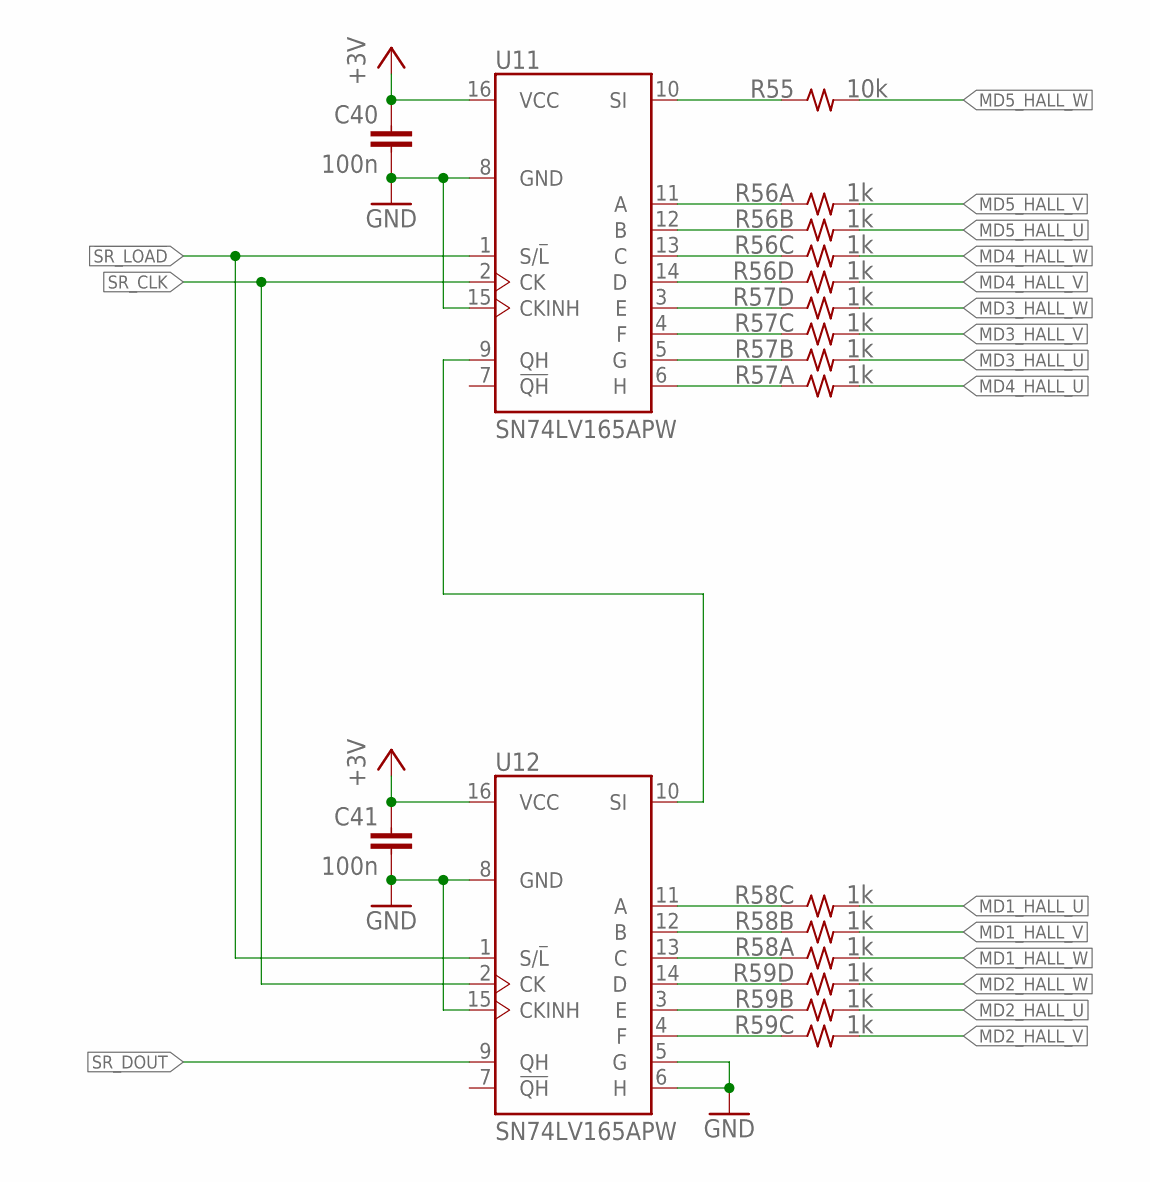
[picture p13: schematic toro10.sch, sheet 8, MD Digital]

Parts:
C40, C41: 100n; 1608
R55: 10k; 1608
R56, R57, R58, R59: 1k; 1608-4A
U11, U12: SN74LV165APW; TSSOP16

Connections:
!SR_LOAD: U11.1 (S/!L), U12.1 (S/!L); also elsewhere on the board
+3V: C40.1, C41.1, U11.16 (VCC), U12.16 (VCC); also elsewhere on the board
GND: C40.2, C41.2, U11.8 (GND), U11.15 (CKINH), U12.5 (G), U12.6 (H), U12.8 (GND), U12.15 (CKINH); also elsewhere on the board
MD1_HALL_U: R58.C2 (2); also elsewhere on the board
MD1_HALL_V: R58.B2 (2); also elsewhere on the board
MD1_HALL_W: R58.A2 (2); also elsewhere on the board
MD2_HALL_U: R59.B2 (2); also elsewhere on the board
MD2_HALL_V: R59.C2 (2); also elsewhere on the board
MD2_HALL_W: R59.D2 (2); also elsewhere on the board
MD3_HALL_U: R57.B2 (2); also elsewhere on the board
MD3_HALL_V: R57.C2 (2); also elsewhere on the board
MD3_HALL_W: R57.D2 (2); also elsewhere on the board
MD4_HALL_U: R57.A2 (2); also elsewhere on the board
MD4_HALL_V: R56.D2 (2); also elsewhere on the board
MD4_HALL_W: R56.C2 (2); also elsewhere on the board
MD5_HALL_U: R56.B2 (2); also elsewhere on the board
MD5_HALL_V: R56.A2 (2); also elsewhere on the board
MD5_HALL_W: R55.2; also elsewhere on the board
unnamed: R59.B1 (1), U12.3 (E)
unnamed: R59.C1 (1), U12.4 (F)
unnamed: R59.D1 (1), U12.14 (D)
unnamed: R58.A1 (1), U12.13 (C)
unnamed: R58.B1 (1), U12.12 (B)
unnamed: R58.C1 (1), U12.11 (A)
unnamed: U11.9 (QH), U12.10 (SI)
unnamed: R57.D1 (1), U11.3 (E)
unnamed: R57.C1 (1), U11.4 (F)
unnamed: R57.B1 (1), U11.5 (G)
unnamed: R57.A1 (1), U11.6 (H)
unnamed: R56.D1 (1), U11.14 (D)
unnamed: R56.C1 (1), U11.13 (C)
unnamed: R56.B1 (1), U11.12 (B)
unnamed: R56.A1 (1), U11.11 (A)
unnamed: R55.1, U11.10 (SI)
SR_CLK: U11.2 (CK), U12.2 (CK); also elsewhere on the board
SR_DOUT: U12.9 (QH); also elsewhere on the board

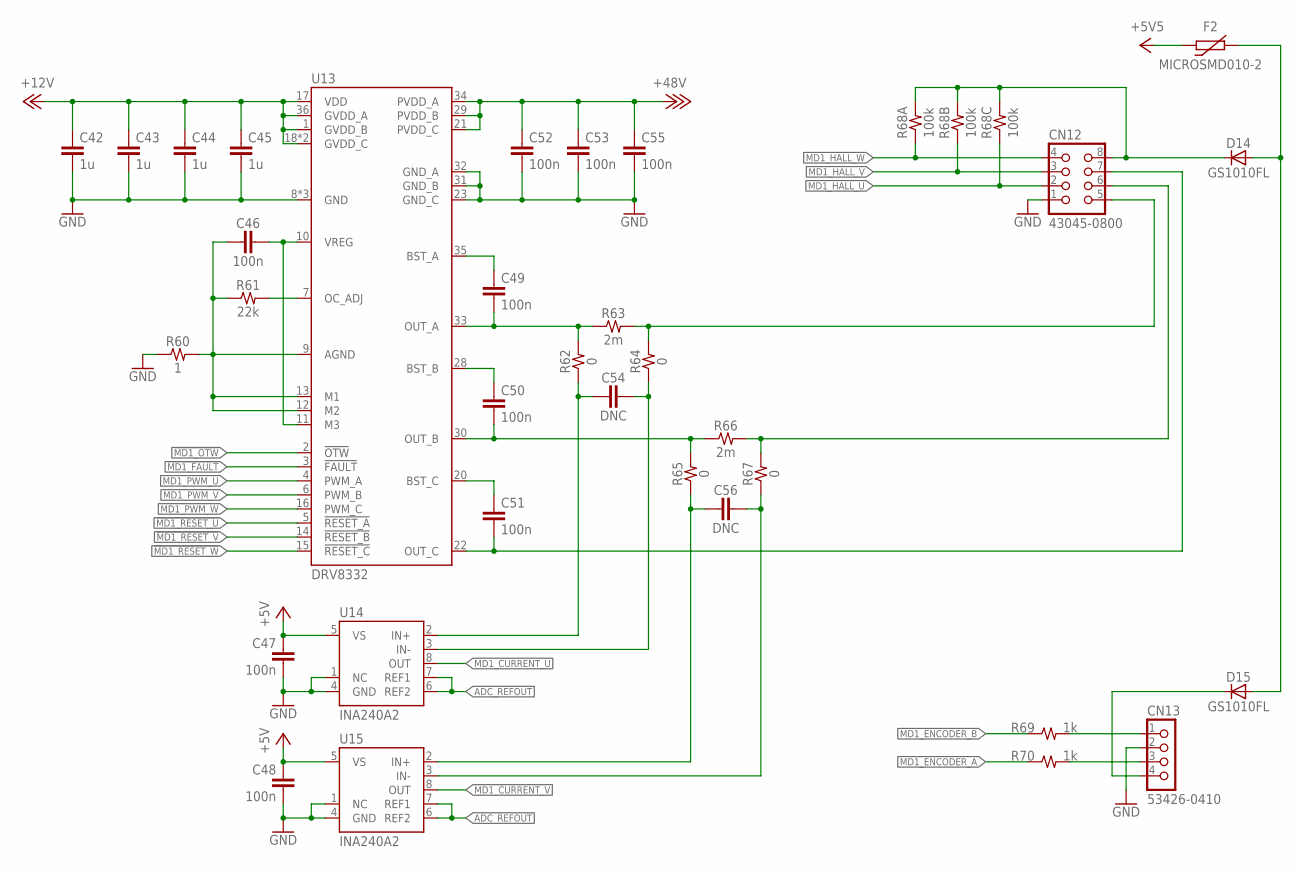
[picture p14: schematic toro10.sch, sheet 9, MD1]

Parts:
C42, C43, C44, C45: 1u; 1608
C46, C47, C48, C49, C50, C51, C52, C53, C55: 100n; 1608
C54, C56: DNC; 1608
CN12: 43045-0800
CN13: 53426-0410; 53426-04
D14, D15: GS1010FL; SOD123
F2: MICROSMD010-2; 3225
R60: 1; 1608
R61: 22k; 1608
R62, R64, R65, R67: 0; 1608
R63, R66: 2m; 3216
R68: 100k; 1608-4A
R69, R70: 1k; 1608
U13: DRV8332; HSSOP36
U14, U15: INA240A2; TSSOP8

Connections:
!MD1_FAULT: U13.3 (!FAULT); also elsewhere on the board
!MD1_OTW: U13.2 (!OTW); also elsewhere on the board
!MD1_RESET_U: U13.5 (!RESET_A); also elsewhere on the board
!MD1_RESET_V: U13.14 (!RESET_B); also elsewhere on the board
!MD1_RESET_W: U13.15 (!RESET_C); also elsewhere on the board
+5V: C47.1, C48.1, U14.5 (VS), U15.5 (VS); also elsewhere on the board
+5V5: F2.1; also elsewhere on the board
+12V: C42.1, C43.1, C44.1, C45.1, U13.1 (GVDD_B), U13.17 (VDD), U13.18 (GVDD_C), U13.19 (GVDD_C), U13.36 (GVDD_A); also elsewhere on the board
+48V: C52.1, C53.1, C55.1, U13.21 (PVDD_C), U13.29 (PVDD_B), U13.34 (PVDD_A); also elsewhere on the board
ADC_REFOUT: U14.6 (REF2), U14.7 (REF1), U15.6 (REF2), U15.7 (REF1); also elsewhere on the board
GND: C42.2, C43.2, C44.2, C45.2, C47.2, C48.2, C52.2, C53.2, C55.2, CN12.1, CN13.2, R60.1, U13.8 (GND), U13.23 (GND_C), U13.24 (GND), U13.25 (GND), U13.31 (GND_B), U13.32 (GND_A), U14.1 (NC), U14.4 (GND), U15.1 (NC), U15.4 (GND); also elsewhere on the board
MD1_CURRENT_U: U14.8 (OUT); also elsewhere on the board
MD1_CURRENT_V: U15.8 (OUT); also elsewhere on the board
MD1_ENCODER_A: R70.1; also elsewhere on the board
MD1_ENCODER_B: R69.1; also elsewhere on the board
MD1_HALL_U: CN12.2, R68.C1 (1); also elsewhere on the board
MD1_HALL_V: CN12.3, R68.B1 (1); also elsewhere on the board
MD1_HALL_W: CN12.4, R68.A1 (1); also elsewhere on the board
MD1_PWM_U: U13.4 (PWM_A); also elsewhere on the board
MD1_PWM_V: U13.6 (PWM_B); also elsewhere on the board
MD1_PWM_W: U13.16 (PWM_C); also elsewhere on the board
unnamed: C49.2, R62.2, R63.1, U13.33 (OUT_A)
unnamed: CN12.5, R63.2, R64.2
unnamed: R61.2, U13.7 (OC_ADJ)
unnamed: C46.2, U13.10 (VREG), U13.11 (M3)
unnamed: C46.1, R60.2, R61.1, U13.9 (AGND), U13.12 (M2), U13.13 (M1)
unnamed: C51.2, CN12.7, U13.22 (OUT_C)
unnamed: C56.1, R65.1, U15.2 (IN+)
unnamed: C54.1, R62.1, U14.2 (IN+)
unnamed: C49.1, U13.35 (BST_A)
unnamed: C50.1, U13.28 (BST_B)
unnamed: C51.1, U13.20 (BST_C)
unnamed: CN13.1, R69.2
unnamed: C54.2, R64.1, U14.3 (IN-)
unnamed: C56.2, R67.1, U15.3 (IN-)
unnamed: D14.A, D15.A, F2.2
unnamed: CN13.4, D15.K
unnamed: CN12.8, D14.K, R68.A2 (2), R68.B2 (2), R68.C2 (2)
unnamed: CN13.3, R70.2
unnamed: C50.2, R65.2, R66.1, U13.30 (OUT_B)
unnamed: CN12.6, R66.2, R67.2

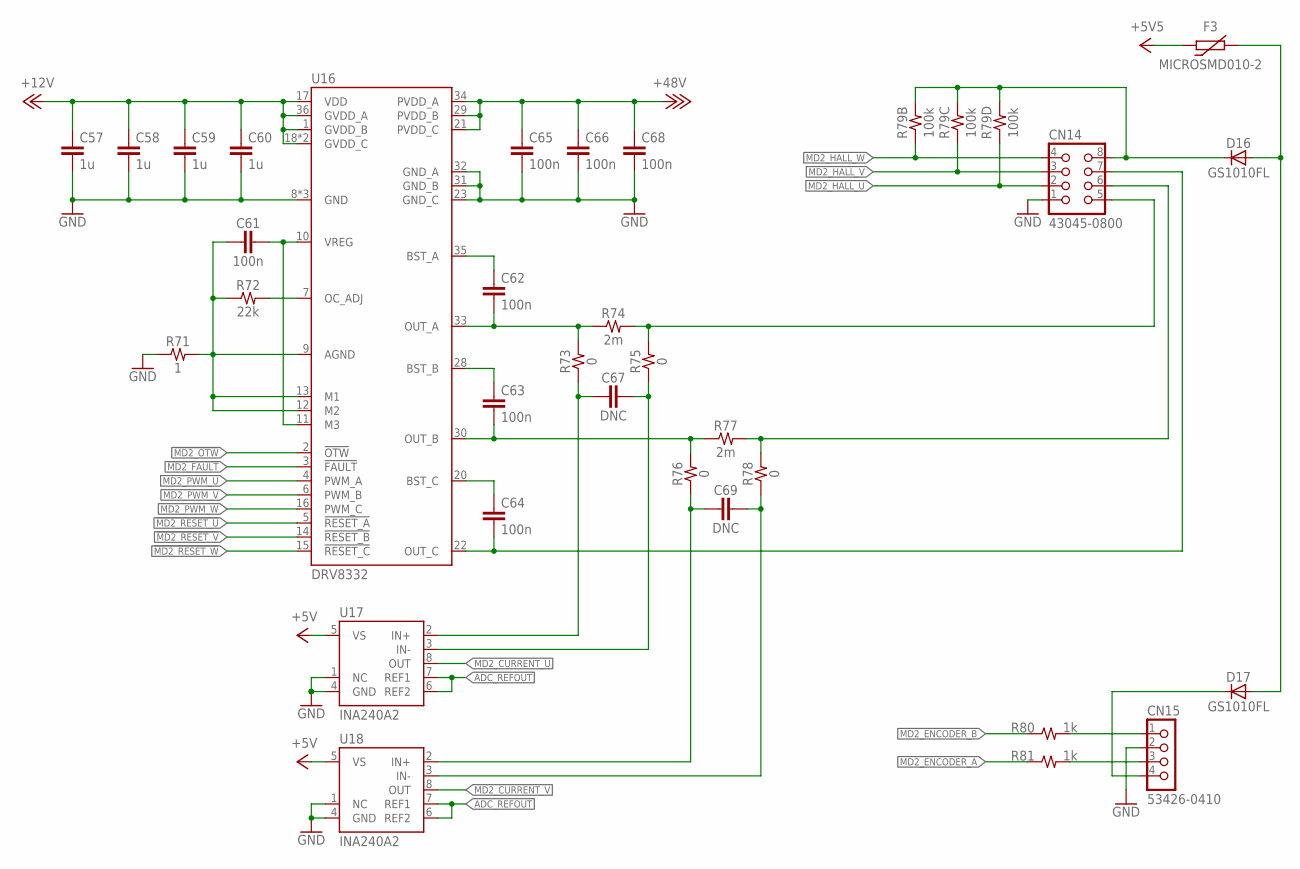
[picture p15: schematic toro10.sch, sheet 10, MD2]

Parts:
C57, C58, C59, C60: 1u; 1608
C61, C62, C63, C64, C65, C66, C68: 100n; 1608
C67, C69: DNC; 1608
CN14: 43045-0800
CN15: 53426-0410; 53426-04
D16, D17: GS1010FL; SOD123
F3: MICROSMD010-2; 3225
R71: 1; 1608
R72: 22k; 1608
R73, R75, R76, R78: 0; 1608
R74, R77: 2m; 3216
R79: 100k; 1608-4A
R80, R81: 1k; 1608
U16: DRV8332; HSSOP36
U17, U18: INA240A2; TSSOP8

Connections:
!MD2_FAULT: U16.3 (!FAULT); also elsewhere on the board
!MD2_OTW: U16.2 (!OTW); also elsewhere on the board
!MD2_RESET_U: U16.5 (!RESET_A); also elsewhere on the board
!MD2_RESET_V: U16.14 (!RESET_B); also elsewhere on the board
!MD2_RESET_W: U16.15 (!RESET_C); also elsewhere on the board
+5V: U17.5 (VS), U18.5 (VS); also elsewhere on the board
+5V5: F3.1; also elsewhere on the board
+12V: C57.1, C58.1, C59.1, C60.1, U16.1 (GVDD_B), U16.17 (VDD), U16.18 (GVDD_C), U16.19 (GVDD_C), U16.36 (GVDD_A); also elsewhere on the board
+48V: C65.1, C66.1, C68.1, U16.21 (PVDD_C), U16.29 (PVDD_B), U16.34 (PVDD_A); also elsewhere on the board
ADC_REFOUT: U17.6 (REF2), U17.7 (REF1), U18.6 (REF2), U18.7 (REF1); also elsewhere on the board
GND: C57.2, C58.2, C59.2, C60.2, C65.2, C66.2, C68.2, CN14.1, CN15.2, R71.1, U16.8 (GND), U16.23 (GND_C), U16.24 (GND), U16.25 (GND), U16.31 (GND_B), U16.32 (GND_A), U17.1 (NC), U17.4 (GND), U18.1 (NC), U18.4 (GND); also elsewhere on the board
MD2_CURRENT_U: U17.8 (OUT); also elsewhere on the board
MD2_CURRENT_V: U18.8 (OUT); also elsewhere on the board
MD2_ENCODER_A: R81.1; also elsewhere on the board
MD2_ENCODER_B: R80.1; also elsewhere on the board
MD2_HALL_U: CN14.2, R79.D1 (1); also elsewhere on the board
MD2_HALL_V: CN14.3, R79.C1 (1); also elsewhere on the board
MD2_HALL_W: CN14.4, R79.B1 (1); also elsewhere on the board
MD2_PWM_U: U16.4 (PWM_A); also elsewhere on the board
MD2_PWM_V: U16.6 (PWM_B); also elsewhere on the board
MD2_PWM_W: U16.16 (PWM_C); also elsewhere on the board
unnamed: R72.2, U16.7 (OC_ADJ)
unnamed: C61.2, U16.10 (VREG), U16.11 (M3)
unnamed: C61.1, R71.2, R72.1, U16.9 (AGND), U16.12 (M2), U16.13 (M1)
unnamed: C64.2, CN14.7, U16.22 (OUT_C)
unnamed: C69.1, R76.1, U18.2 (IN+)
unnamed: C67.1, R73.1, U17.2 (IN+)
unnamed: C62.1, U16.35 (BST_A)
unnamed: C63.1, U16.28 (BST_B)
unnamed: C64.1, U16.20 (BST_C)
unnamed: CN14.8, D16.K, R79.B2 (2), R79.C2 (2), R79.D2 (2)
unnamed: C67.2, R75.1, U17.3 (IN-)
unnamed: C69.2, R78.1, U18.3 (IN-)
unnamed: CN15.4, D17.K
unnamed: D16.A, D17.A, F3.2
unnamed: C62.2, R73.2, R74.1, U16.33 (OUT_A)
unnamed: CN14.5, R74.2, R75.2
unnamed: C63.2, R76.2, R77.1, U16.30 (OUT_B)
unnamed: CN14.6, R77.2, R78.2
unnamed: CN15.1, R80.2
unnamed: CN15.3, R81.2

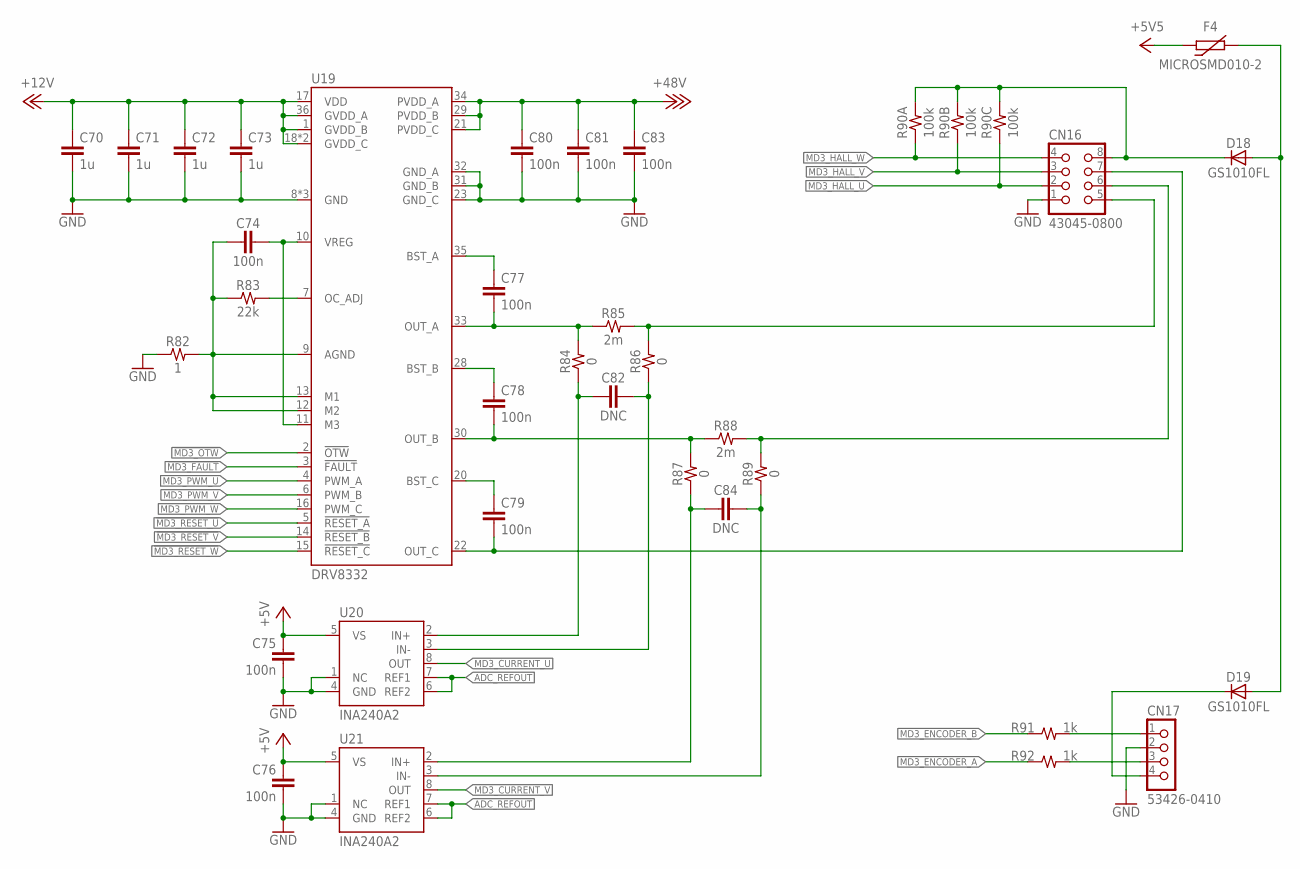
[picture p16: schematic toro10.sch, sheet 11, MD3]

Parts:
C70, C71, C72, C73: 1u; 1608
C74, C75, C76, C77, C78, C79, C80, C81, C83: 100n; 1608
C82, C84: DNC; 1608
CN16: 43045-0800
CN17: 53426-0410; 53426-04
D18, D19: GS1010FL; SOD123
F4: MICROSMD010-2; 3225
R82: 1; 1608
R83: 22k; 1608
R84, R86, R87, R89: 0; 1608
R85, R88: 2m; 3216
R90: 100k; 1608-4A
R91, R92: 1k; 1608
U19: DRV8332; HSSOP36
U20, U21: INA240A2; TSSOP8

Connections:
!MD3_FAULT: U19.3 (!FAULT); also elsewhere on the board
!MD3_OTW: U19.2 (!OTW); also elsewhere on the board
!MD3_RESET_U: U19.5 (!RESET_A); also elsewhere on the board
!MD3_RESET_V: U19.14 (!RESET_B); also elsewhere on the board
!MD3_RESET_W: U19.15 (!RESET_C); also elsewhere on the board
+5V: C75.1, C76.1, U20.5 (VS), U21.5 (VS); also elsewhere on the board
+5V5: F4.1; also elsewhere on the board
+12V: C70.1, C71.1, C72.1, C73.1, U19.1 (GVDD_B), U19.17 (VDD), U19.18 (GVDD_C), U19.19 (GVDD_C), U19.36 (GVDD_A); also elsewhere on the board
+48V: C80.1, C81.1, C83.1, U19.21 (PVDD_C), U19.29 (PVDD_B), U19.34 (PVDD_A); also elsewhere on the board
ADC_REFOUT: U20.6 (REF2), U20.7 (REF1), U21.6 (REF2), U21.7 (REF1); also elsewhere on the board
GND: C70.2, C71.2, C72.2, C73.2, C75.2, C76.2, C80.2, C81.2, C83.2, CN16.1, CN17.2, R82.1, U19.8 (GND), U19.23 (GND_C), U19.24 (GND), U19.25 (GND), U19.31 (GND_B), U19.32 (GND_A), U20.1 (NC), U20.4 (GND), U21.1 (NC), U21.4 (GND); also elsewhere on the board
MD3_CURRENT_U: U20.8 (OUT); also elsewhere on the board
MD3_CURRENT_V: U21.8 (OUT); also elsewhere on the board
MD3_ENCODER_A: R92.1; also elsewhere on the board
MD3_ENCODER_B: R91.1; also elsewhere on the board
MD3_HALL_U: CN16.2, R90.C1 (1); also elsewhere on the board
MD3_HALL_V: CN16.3, R90.B1 (1); also elsewhere on the board
MD3_HALL_W: CN16.4, R90.A1 (1); also elsewhere on the board
MD3_PWM_U: U19.4 (PWM_A); also elsewhere on the board
MD3_PWM_V: U19.6 (PWM_B); also elsewhere on the board
MD3_PWM_W: U19.16 (PWM_C); also elsewhere on the board
unnamed: R83.2, U19.7 (OC_ADJ)
unnamed: C74.2, U19.10 (VREG), U19.11 (M3)
unnamed: C74.1, R82.2, R83.1, U19.9 (AGND), U19.12 (M2), U19.13 (M1)
unnamed: C79.2, CN16.7, U19.22 (OUT_C)
unnamed: C84.1, R87.1, U21.2 (IN+)
unnamed: C82.1, R84.1, U20.2 (IN+)
unnamed: C77.1, U19.35 (BST_A)
unnamed: C78.1, U19.28 (BST_B)
unnamed: C79.1, U19.20 (BST_C)
unnamed: CN16.8, D18.K, R90.A2 (2), R90.B2 (2), R90.C2 (2)
unnamed: C82.2, R86.1, U20.3 (IN-)
unnamed: C84.2, R89.1, U21.3 (IN-)
unnamed: CN17.4, D19.K
unnamed: D18.A, D19.A, F4.2
unnamed: C77.2, R84.2, R85.1, U19.33 (OUT_A)
unnamed: CN16.5, R85.2, R86.2
unnamed: C78.2, R87.2, R88.1, U19.30 (OUT_B)
unnamed: CN16.6, R88.2, R89.2
unnamed: CN17.1, R91.2
unnamed: CN17.3, R92.2
