Nkyoku/toro10_repo/TORO10Board/toro10.brd

## EAGLE design TORO10Board/toro10.brd (continued)

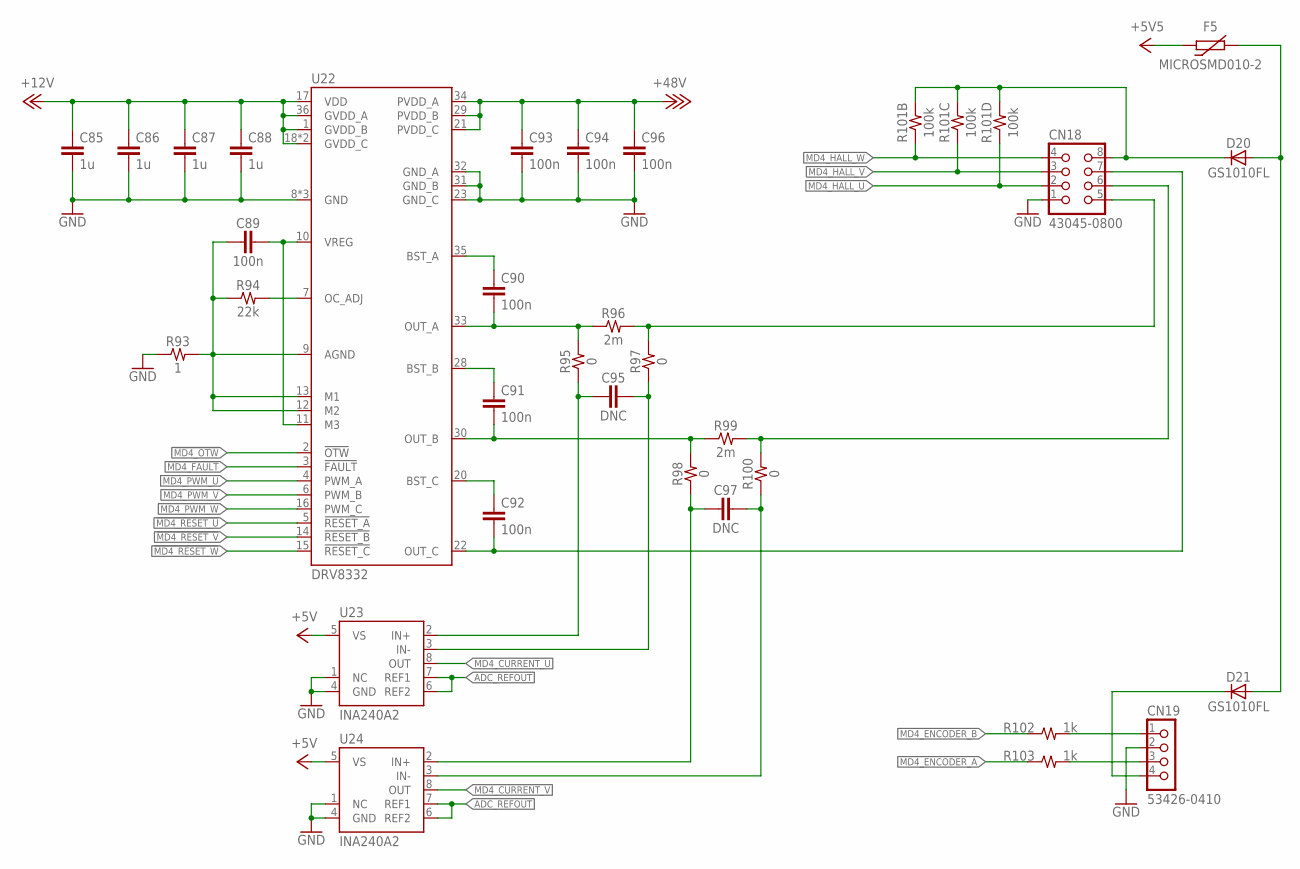
[picture p17: schematic toro10.sch, sheet 12, MD4]

Parts:
C85, C86, C87, C88: 1u; 1608
C89, C90, C91, C92, C93, C94, C96: 100n; 1608
C95, C97: DNC; 1608
CN18: 43045-0800
CN19: 53426-0410; 53426-04
D20, D21: GS1010FL; SOD123
F5: MICROSMD010-2; 3225
R93: 1; 1608
R94: 22k; 1608
R95, R97, R98, R100: 0; 1608
R96, R99: 2m; 3216
R101: 100k; 1608-4A
R102, R103: 1k; 1608
U22: DRV8332; HSSOP36
U23, U24: INA240A2; TSSOP8

Connections:
!MD4_FAULT: U22.3 (!FAULT); also elsewhere on the board
!MD4_OTW: U22.2 (!OTW); also elsewhere on the board
!MD4_RESET_U: U22.5 (!RESET_A); also elsewhere on the board
!MD4_RESET_V: U22.14 (!RESET_B); also elsewhere on the board
!MD4_RESET_W: U22.15 (!RESET_C); also elsewhere on the board
+5V: U23.5 (VS), U24.5 (VS); also elsewhere on the board
+5V5: F5.1; also elsewhere on the board
+12V: C85.1, C86.1, C87.1, C88.1, U22.1 (GVDD_B), U22.17 (VDD), U22.18 (GVDD_C), U22.19 (GVDD_C), U22.36 (GVDD_A); also elsewhere on the board
+48V: C93.1, C94.1, C96.1, U22.21 (PVDD_C), U22.29 (PVDD_B), U22.34 (PVDD_A); also elsewhere on the board
ADC_REFOUT: U23.6 (REF2), U23.7 (REF1), U24.6 (REF2), U24.7 (REF1); also elsewhere on the board
GND: C85.2, C86.2, C87.2, C88.2, C93.2, C94.2, C96.2, CN18.1, CN19.2, R93.1, U22.8 (GND), U22.23 (GND_C), U22.24 (GND), U22.25 (GND), U22.31 (GND_B), U22.32 (GND_A), U23.1 (NC), U23.4 (GND), U24.1 (NC), U24.4 (GND); also elsewhere on the board
MD4_CURRENT_U: U23.8 (OUT); also elsewhere on the board
MD4_CURRENT_V: U24.8 (OUT); also elsewhere on the board
MD4_ENCODER_A: R103.1; also elsewhere on the board
MD4_ENCODER_B: R102.1; also elsewhere on the board
MD4_HALL_U: CN18.2, R101.D1 (1); also elsewhere on the board
MD4_HALL_V: CN18.3, R101.C1 (1); also elsewhere on the board
MD4_HALL_W: CN18.4, R101.B1 (1); also elsewhere on the board
MD4_PWM_U: U22.4 (PWM_A); also elsewhere on the board
MD4_PWM_V: U22.6 (PWM_B); also elsewhere on the board
MD4_PWM_W: U22.16 (PWM_C); also elsewhere on the board
unnamed: R94.2, U22.7 (OC_ADJ)
unnamed: C89.2, U22.10 (VREG), U22.11 (M3)
unnamed: C89.1, R93.2, R94.1, U22.9 (AGND), U22.12 (M2), U22.13 (M1)
unnamed: C92.2, CN18.7, U22.22 (OUT_C)
unnamed: C97.1, R98.1, U24.2 (IN+)
unnamed: C95.1, R95.1, U23.2 (IN+)
unnamed: C90.1, U22.35 (BST_A)
unnamed: C91.1, U22.28 (BST_B)
unnamed: C92.1, U22.20 (BST_C)
unnamed: CN18.8, D20.K, R101.B2 (2), R101.C2 (2), R101.D2 (2)
unnamed: C95.2, R97.1, U23.3 (IN-)
unnamed: C97.2, R100.1, U24.3 (IN-)
unnamed: CN19.4, D21.K
unnamed: D20.A, D21.A, F5.2
unnamed: C90.2, R95.2, R96.1, U22.33 (OUT_A)
unnamed: CN18.5, R96.2, R97.2
unnamed: C91.2, R98.2, R99.1, U22.30 (OUT_B)
unnamed: CN18.6, R99.2, R100.2
unnamed: CN19.1, R102.2
unnamed: CN19.3, R103.2

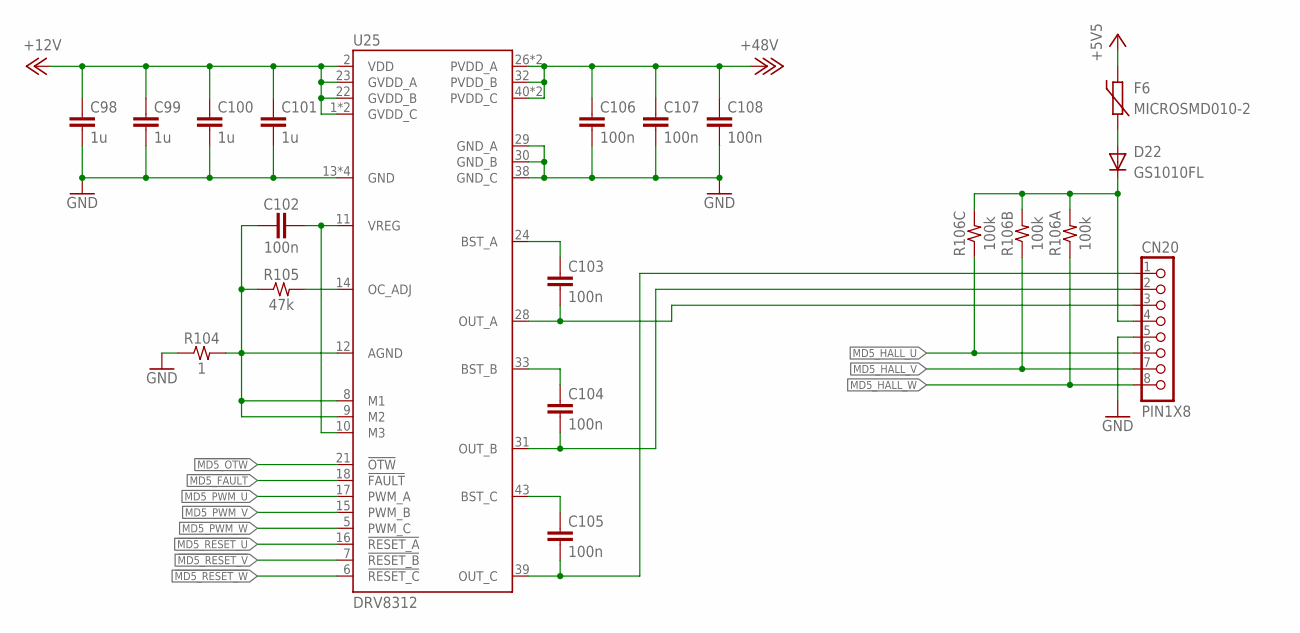
[picture p18: schematic toro10.sch, sheet 13, MD5]

Parts:
C98, C99, C100, C101: 1u; 1608
C102, C103, C104, C105, C106, C107, C108: 100n; 1608
CN20: PIN1X8
D22: GS1010FL; SOD123
F6: MICROSMD010-2; 3225
R104: 1; 1608
R105: 47k; 1608
R106: 100k; 1608-4A
U25: DRV8312; HTSSOP44

Connections:
!MD5_FAULT: U25.18 (!FAULT); also elsewhere on the board
!MD5_OTW: U25.21 (!OTW); also elsewhere on the board
!MD5_RESET_U: U25.16 (!RESET_A); also elsewhere on the board
!MD5_RESET_V: U25.7 (!RESET_B); also elsewhere on the board
!MD5_RESET_W: U25.6 (!RESET_C); also elsewhere on the board
+5V5: F6.1; also elsewhere on the board
+12V: C98.1, C99.1, C100.1, C101.1, U25.1 (GVDD_C), U25.2 (VDD), U25.22 (GVDD_B), U25.23 (GVDD_A), U25.44 (GVDD_C); also elsewhere on the board
+48V: C106.1, C107.1, C108.1, U25.26 (PVDD_A), U25.27 (PVDD_A), U25.32 (PVDD_B), U25.40 (PVDD_C), U25.41 (PVDD_C); also elsewhere on the board
GND: C98.2, C99.2, C100.2, C101.2, C106.2, C107.2, C108.2, CN20.5, R104.1, U25.13 (GND), U25.29 (GND_A), U25.30 (GND_B), U25.36 (GND), U25.37 (GND), U25.38 (GND_C), U25.PAD (GND); also elsewhere on the board
MD5_HALL_U: CN20.6, R106.C1 (1); also elsewhere on the board
MD5_HALL_V: CN20.7, R106.B1 (1); also elsewhere on the board
MD5_HALL_W: CN20.8, R106.A1 (1); also elsewhere on the board
MD5_PWM_U: U25.17 (PWM_A); also elsewhere on the board
MD5_PWM_V: U25.15 (PWM_B); also elsewhere on the board
MD5_PWM_W: U25.5 (PWM_C); also elsewhere on the board
unnamed: CN20.4, D22.K, R106.A2 (2), R106.B2 (2), R106.C2 (2)
unnamed: R105.2, U25.14 (OC_ADJ)
unnamed: D22.A, F6.2
unnamed: C102.2, U25.10 (M3), U25.11 (VREG)
unnamed: C102.1, R104.2, R105.1, U25.8 (M1), U25.9 (M2), U25.12 (AGND)
unnamed: C105.2, CN20.1, U25.39 (OUT_C)
unnamed: C104.2, CN20.2, U25.31 (OUT_B)
unnamed: C103.2, CN20.3, U25.28 (OUT_A)
unnamed: C103.1, U25.24 (BST_A)
unnamed: C104.1, U25.33 (BST_B)
unnamed: C105.1, U25.43 (BST_C)

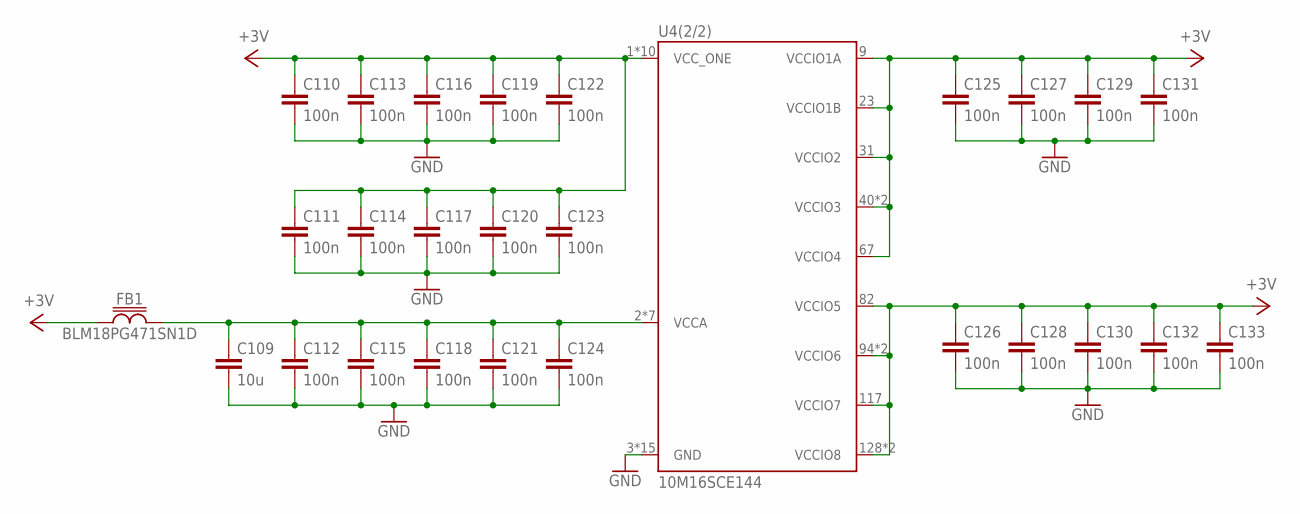
[picture p19: schematic toro10.sch, sheet 14, Decoupling]

Parts:
C109: 10u; 2012
C110, C111, C112, C113, C114, C115, C116, C117, C118, C119, C120, C121, C122, C123, C124, C125, C126, C127, C128, C129, C130, C131, C132, C133: 100n; 1608
FB1: BLM18PG471SN1D; 1608
U4: 10M16SCE144; QFP144-0.5-PAD

Connections:
+3V: C110.1, C111.1, C113.1, C114.1, C116.1, C117.1, C119.1, C120.1, C122.1, C123.1, C125.1, C126.1, C127.1, C128.1, C129.1, C130.1, C131.1, C132.1, C133.1, FB1.1, U4.1 (VCC_ONE), U4.9 (VCCIO1A), U4.23 (VCCIO1B), U4.31 (VCCIO2), U4.36 (VCC_ONE), U4.37 (VCC_ONE), U4.40 (VCCIO3), U4.49 (VCCIO3), U4.51 (VCC_ONE), U4.67 (VCCIO4), U4.72 (VCC_ONE), U4.73 (VCC_ONE), U4.82 (VCCIO5), U4.94 (VCCIO6), U4.103 (VCCIO6), U4.108 (VCC_ONE), U4.109 (VCC_ONE), U4.115 (VCC_ONE), U4.117 (VCCIO7), U4.128 (VCCIO8), U4.139 (VCCIO8), U4.144 (VCC_ONE); also elsewhere on the board
GND: C109.2, C110.2, C111.2, C112.2, C113.2, C114.2, C115.2, C116.2, C117.2, C118.2, C119.2, C120.2, C121.2, C122.2, C123.2, C124.2, C125.2, C126.2, C127.2, C128.2, C129.2, C130.2, C131.2, C132.2, C133.2, U4.3 (GND), U4.4 (GND), U4.42 (GND), U4.53 (GND), U4.63 (GND), U4.68 (GND), U4.83 (GND), U4.95 (GND), U4.104 (GND), U4.116 (GND), U4.125 (GND), U4.133 (GND), U4.137 (GND), U4.142 (GND), U4.PAD (GND); also elsewhere on the board
VCCA: C109.1, C112.1, C115.1, C118.1, C121.1, C124.1, FB1.2, U4.2 (VCCA), U4.5 (VCCA), U4.34 (VCCA), U4.35 (VCCA), U4.71 (VCCA), U4.107 (VCCA), U4.143 (VCCA)

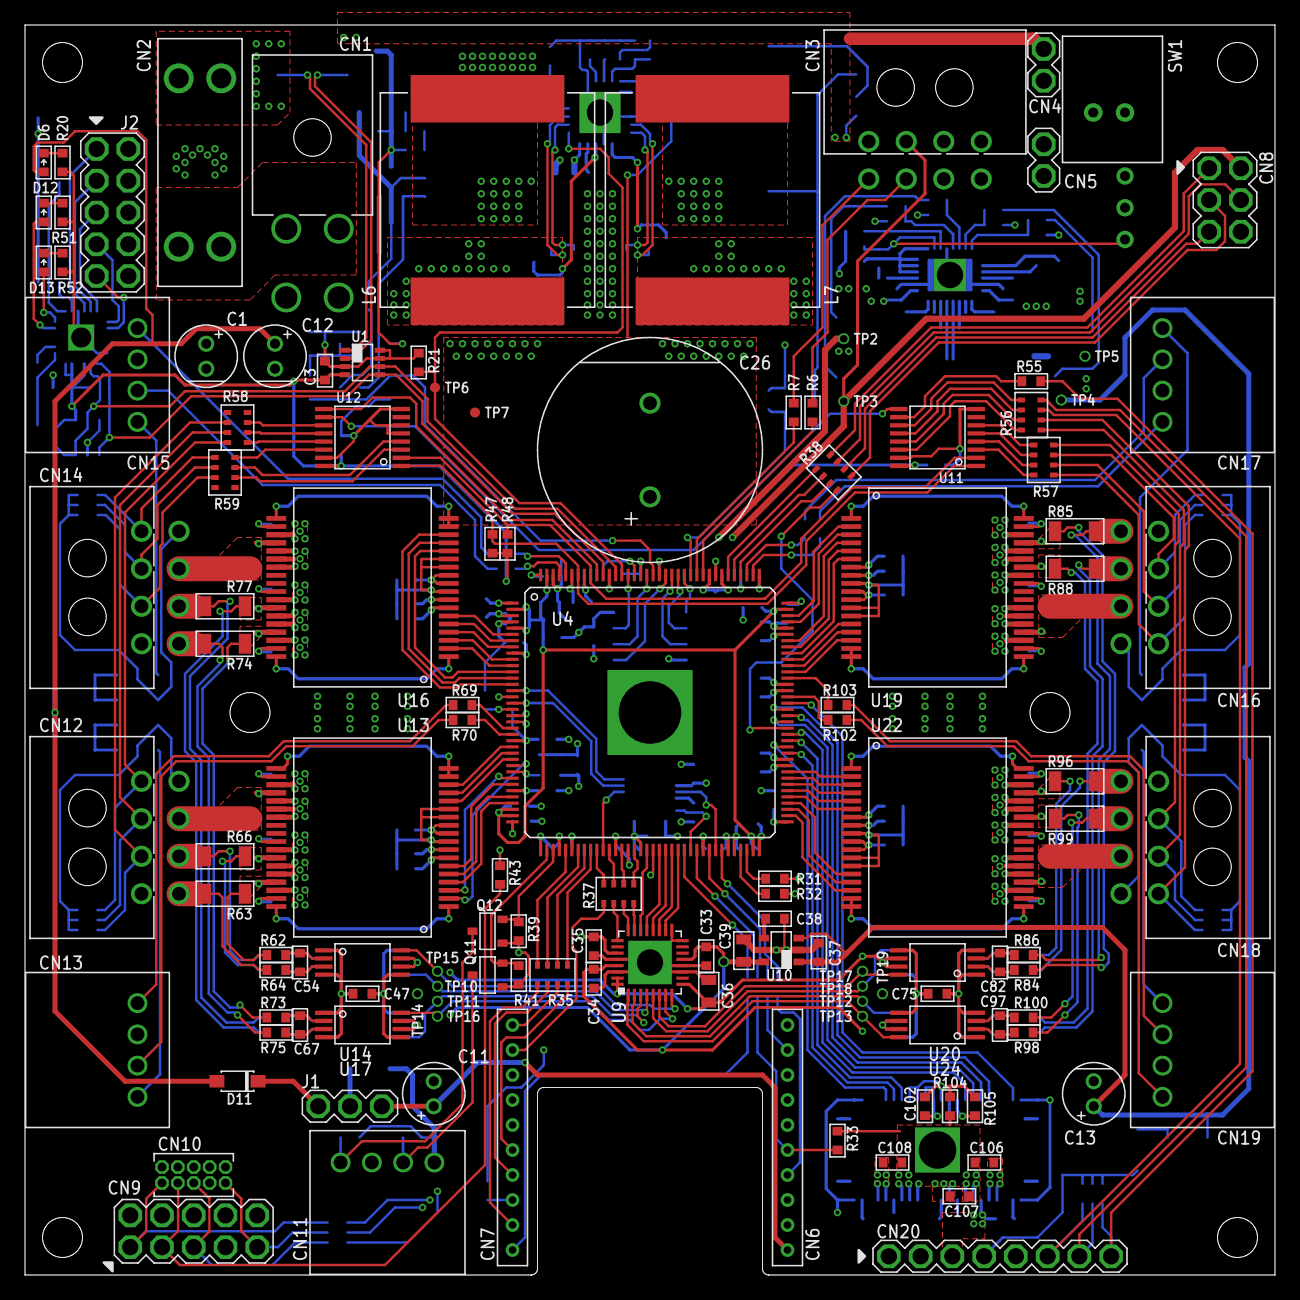
[picture p20: board toro10.brd from above]

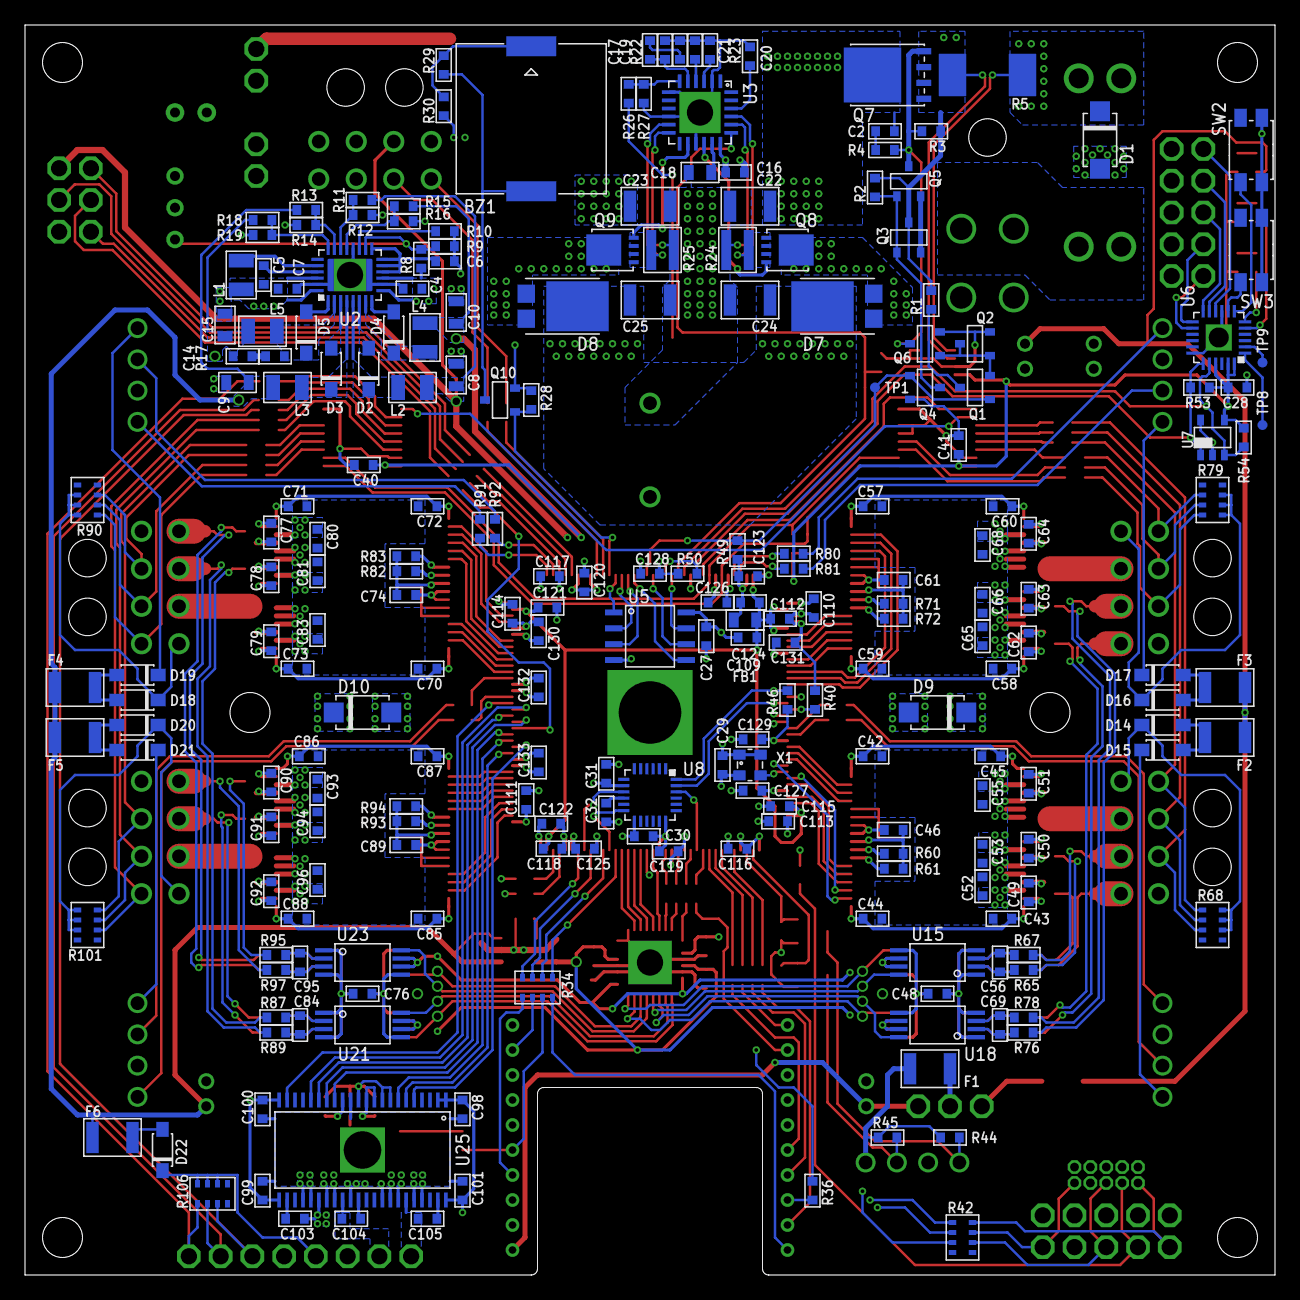
[picture p21: board toro10.brd from below]

Board: 4 copper layers, 100.0 x 100.0 mm, 358 parts (230 on the bottom side), 329 nets.
