Nkyoku/toro10_repo/(commit log)

2017-05-19 Add circuit
    [BOM.xlsx, toro10.brd, toro10.sch]
2017-08-24 add kicker board
    [toro10.brd, toro10.sch, toro10kicker.brd, toro10kicker.sch]
2017-08-24 add kicker BOM
    [BOM.xlsx, toro10kicker.brd, toro10kicker.sch]
